saufik-ramadhan/signalforge/proposal/media/pengujian_ir_read.jpg

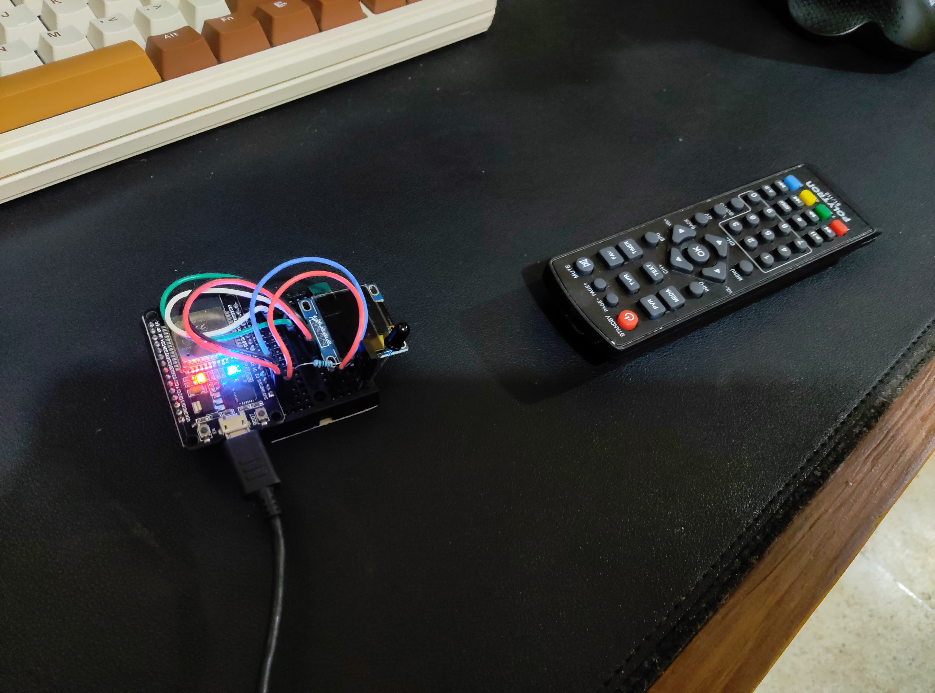
proposal/media/pengujian_ir_read.jpg
