saufik-ramadhan/signalforge/signalforge/Coba Komponen.md

---

kanban-plugin: board

---

## To Buy

- [ ] sx1276
- [ ] batre

## Component

- [ ] pn532
- [ ] oled
- [ ] esp32
- [ ] wifi
- [ ] bms
- [ ] ir

## Try firmware

## Completed

%% kanban:settings
```
{"kanban-plugin":"board","list-collapse":[false,false,false,false]}
```
%%
