saufik-ramadhan/signalforge/proposal/Perancangan_Sistem_Elektronika_4.pptx

## SignalForge (Alat Nirkabel Serbaguna) Implementation and Testing

EL5032 PERANCANGAN SISTEM ELEKTRONIKA
Tim Penyusun:
Mohamad Imam Firdaus (23224002)
Saufik Ramadhan (23222019)


## Abstrak

SignalForge merupakan alat multifungsi untuk penggiat keamanan digital dan siber atau sekadar untuk hobbyst karena kemampuannya untuk membaca, meniru, dan berinteraksi dengan berbagai sinyal radio frekuensi (RF), kartu RFID, dan protokol komunikasi lainnya. Alat ini didesain sebagai alat multi-module yang memudahkan konfigurasi. Setiap modul akan didesain dan diuji dengan metodologi tertentu. Implementasi yang dilakukan secara modular ditujukan agar setiap bagian dapat diverifikasi kesesuaiannya. Pada dokumen ini ditulis kemajuan implementasi dan pengujian dari perangkat keras (hardware) dan perangkat lunak (software) dari setiap modul.

## Pengujian - 1

1. MCU
Microcontroller di hidupkan dan diuji apakah dapat menerima data dari user, dapat membaca data WiFi, dan dapat membaca data Bluetooth.
2. Baterai
Setiap komponen utama menerima suplai daya sesuai dengan kebutuhan dan tidak mengalami drop tegangan dibawah ambang batas.
3. Sub-1 GHz RF module
Berkomunikasi dengan cara mengirimkan text dengan alat sejenis atau alat yang dilengkapi modul yang sama.

## Pengujian - 2

4. Display
Display dapat mengeluarkan button dan teks sesuai program yang ada
5. Buzzer
Dapat mengeluarkan bunyi sebagai feedback.
6. Infrared
Membaca dan mereplay ulang data dari remote. Hasil akan dibandingkan dengan suatu remote control.
7. NFC
Membaca dan menulis data pada generic RFID card.

## Pengujian - 3

8. GPIO
Membaca sinyal dari button yang dipasang secara terpisah dari button utama.
9. MicroSD
Menyimpan suatu text dari user lalu membaca kembali text tersebut setelah daya dimatikan.
10. Body
Body dirangkai dan diperhatikan apakah seluruh komponen terpasang sesuai dengan desain.

## Design Tools 1 – Arduino IDE

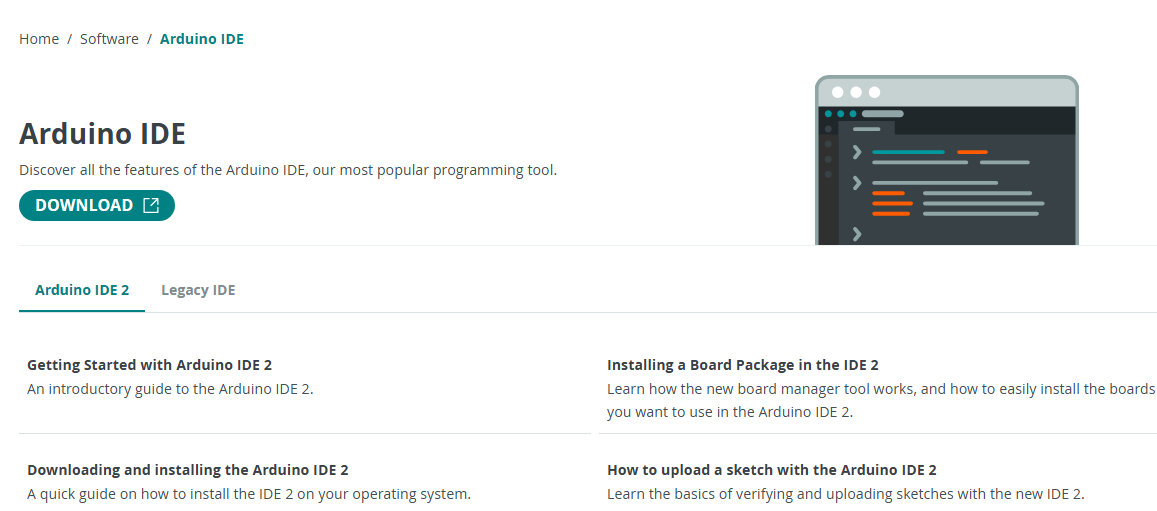
[picture p21: figure]

## Design Tools 2 – Arduino CLI

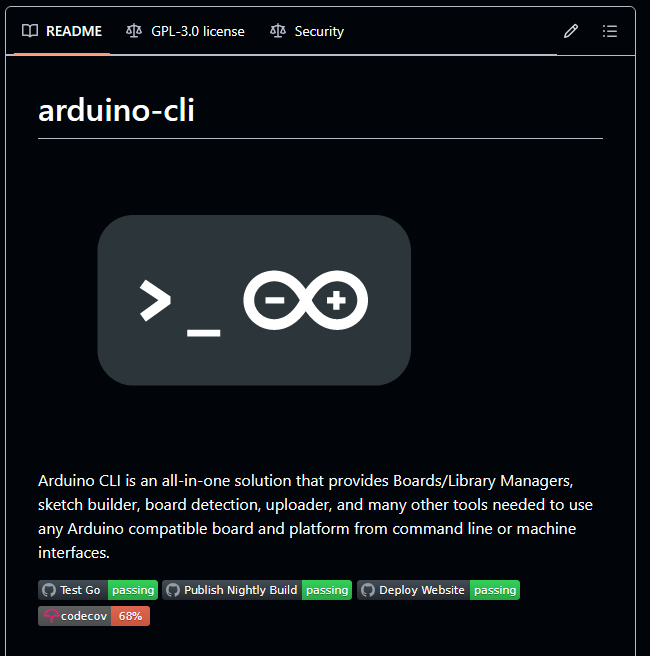
[picture p22: figure]

## Additional Note

- A lot of module means the needs for bigger binary
- Solution:
- Load from SD Card
- Mechanism:
- Use File system module and OTA Module

## Design Tools 3 - FreeCAD

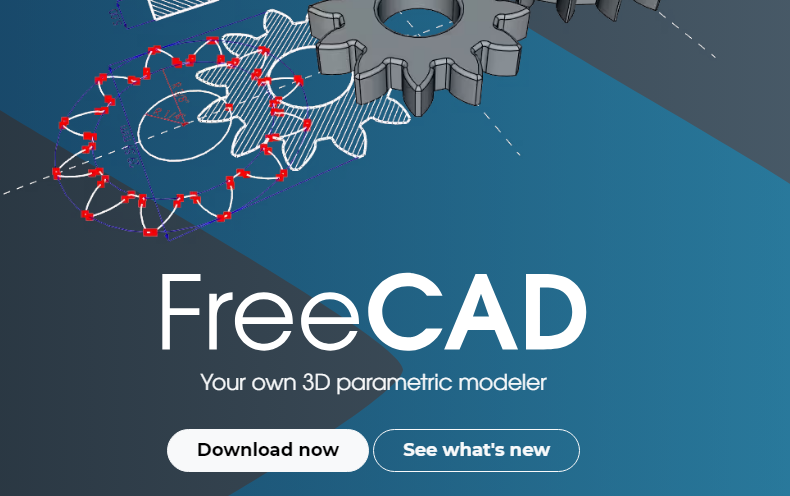
[picture p23: figure]

## Design Tools 4 - KiCad

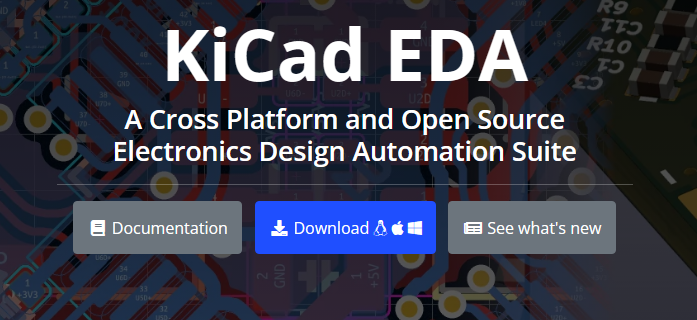
[picture p24: figure]

## Modul 1 – Microcontroller + Wireless

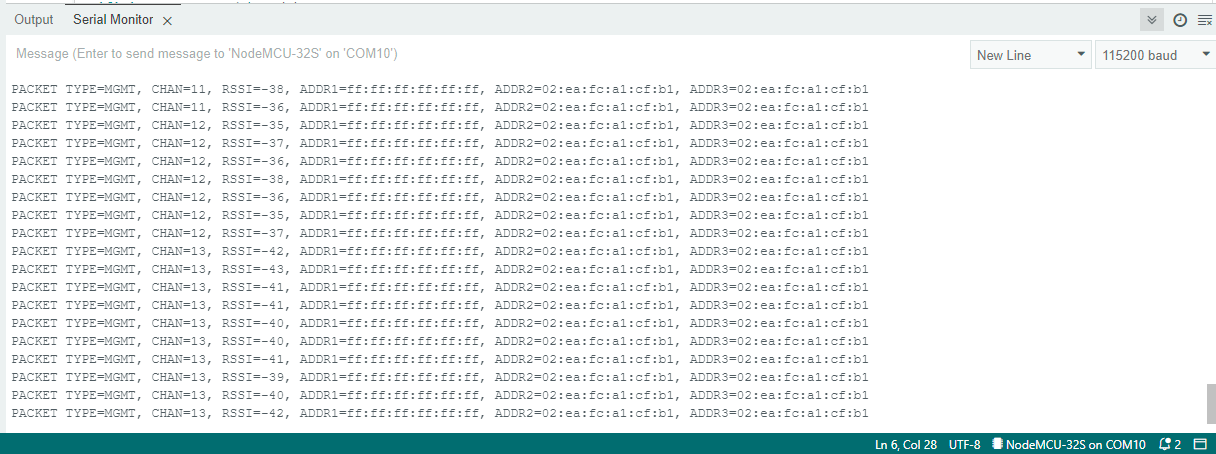
[picture p25: figure]
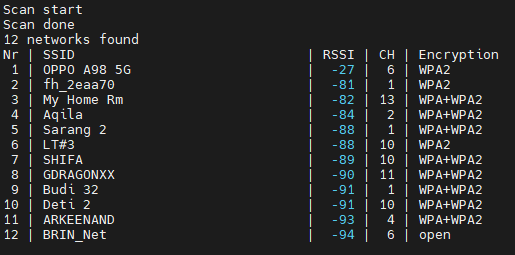
[picture p26: figure]

## Module 1

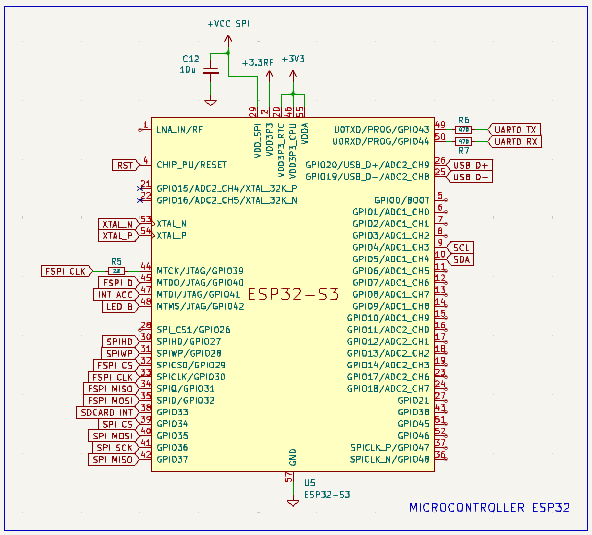
[picture p27: figure]
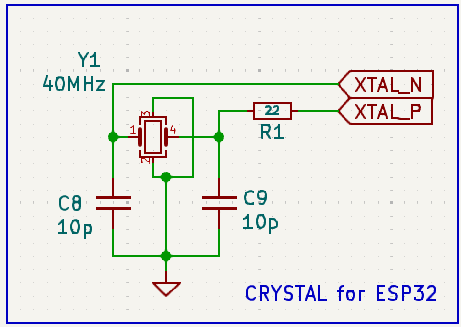
[picture p28: figure]

## Module 1

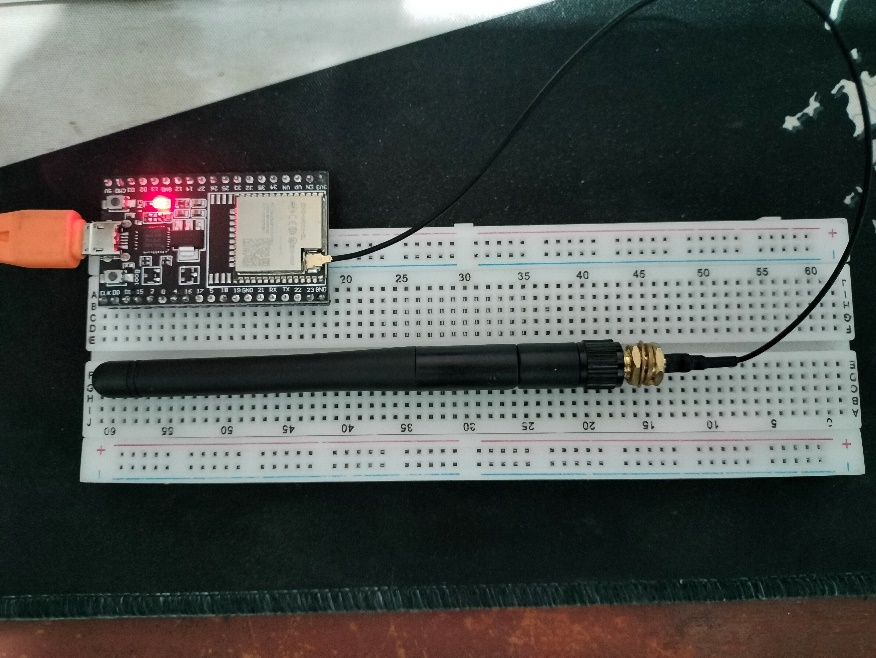
[picture p29: figure]

## Module 2 – Power Electronics

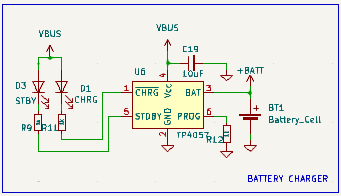
[picture p30: figure]
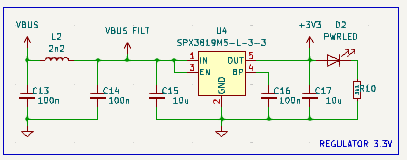
[picture p31: figure]
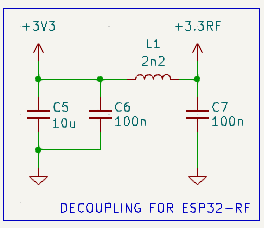
[picture p32: figure]
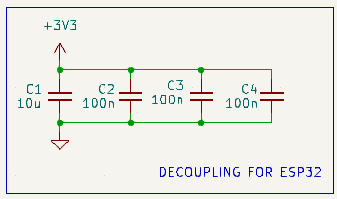
[picture p33: figure]

## Module 3 - RF

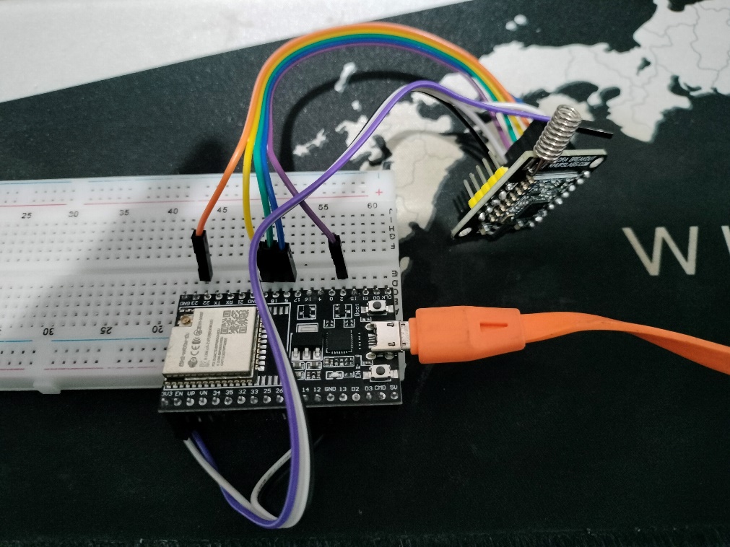
[picture p34: figure]

## Modul 4 – UI Module

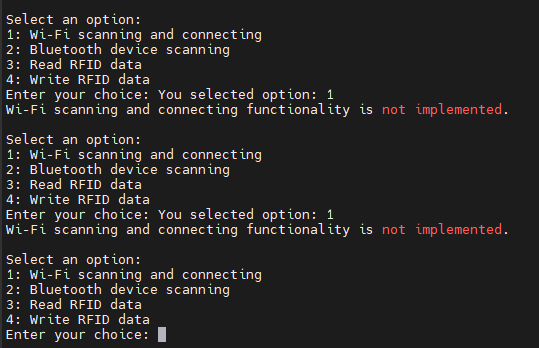
[picture p35: figure]

## Module 4

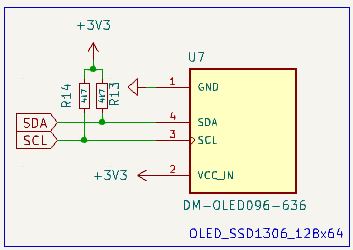
[picture p36: figure]
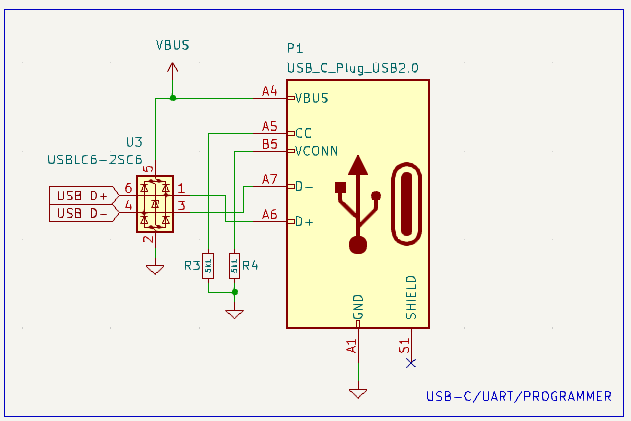
[picture p37: figure]
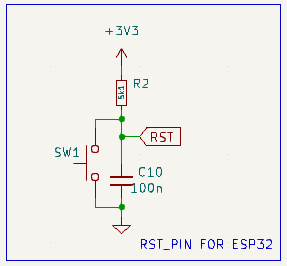
[picture p38: figure]

## Modul 5 – IR Module

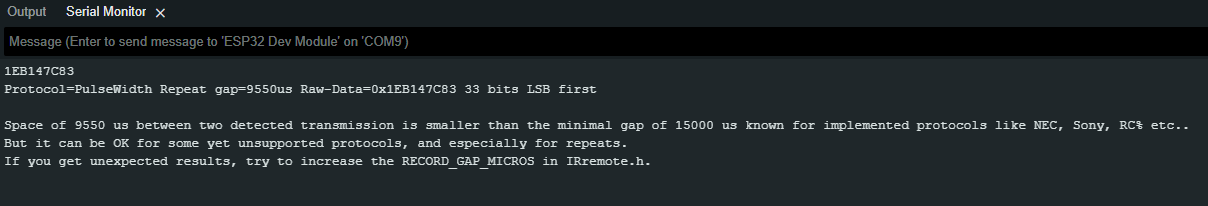
[picture p39: figure]

## Module 5

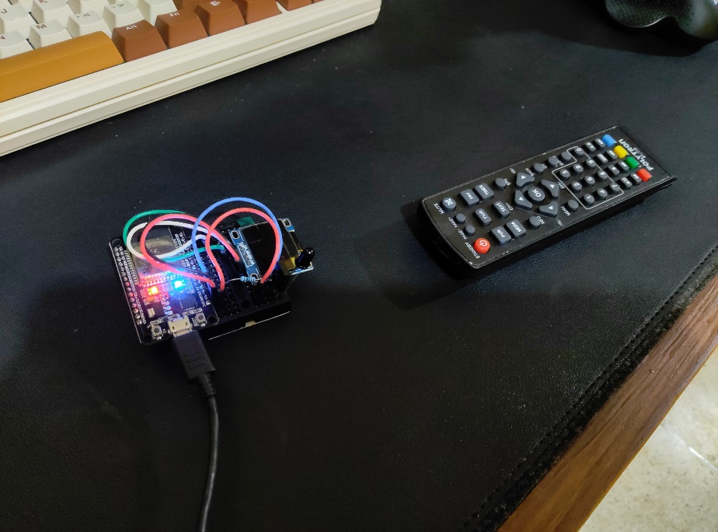
[picture p40: figure]

## Module 5

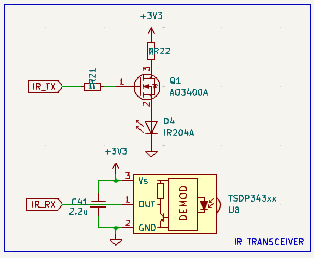
[picture p41: figure]

## Module 6 - NFC

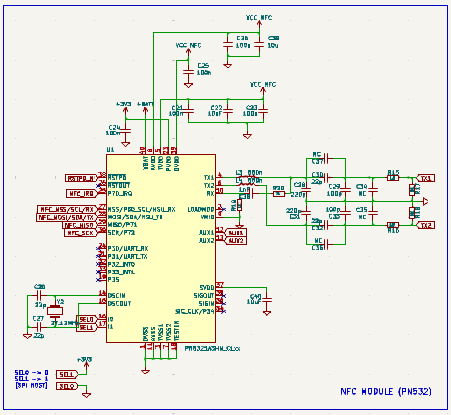
[picture p42: figure]

## Module 6

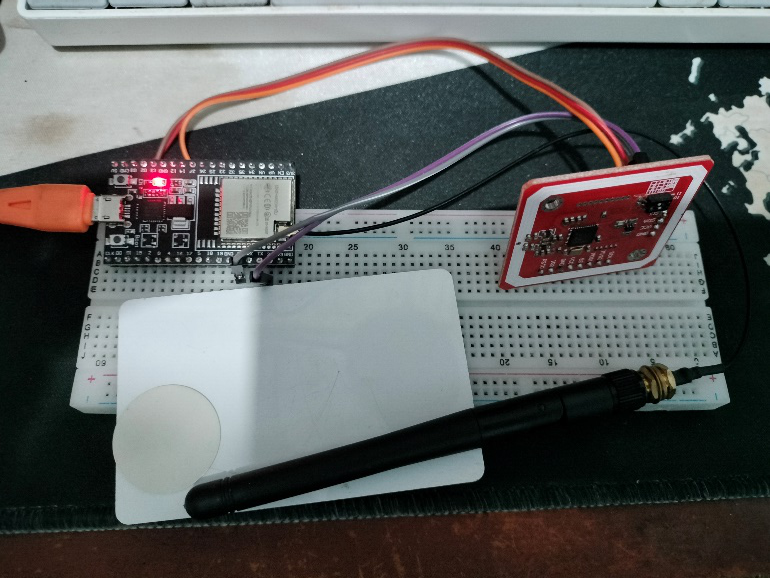
[picture p43: figure]

## Module 7 – Storage

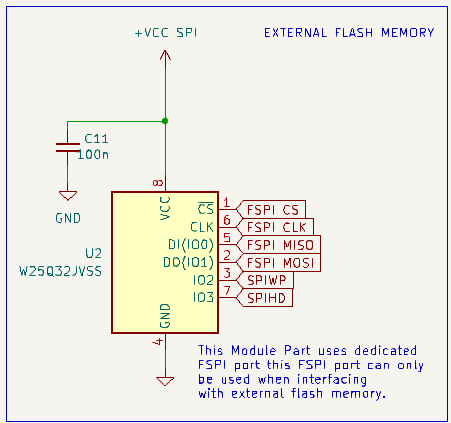
[picture p44: figure]
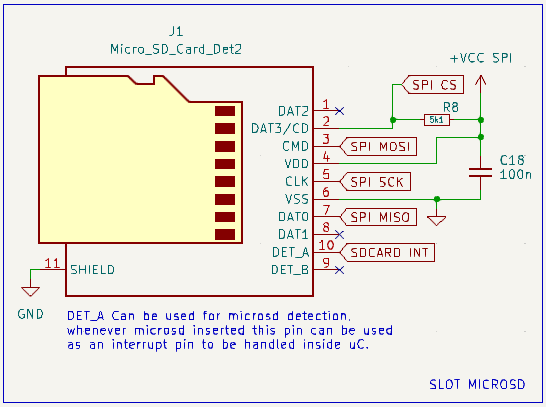
[picture p45: figure]

## Sekian dan Terima Kasih
