saufik-ramadhan/signalforge/hardware/Casing_Acrilic/export_shape4.pdf

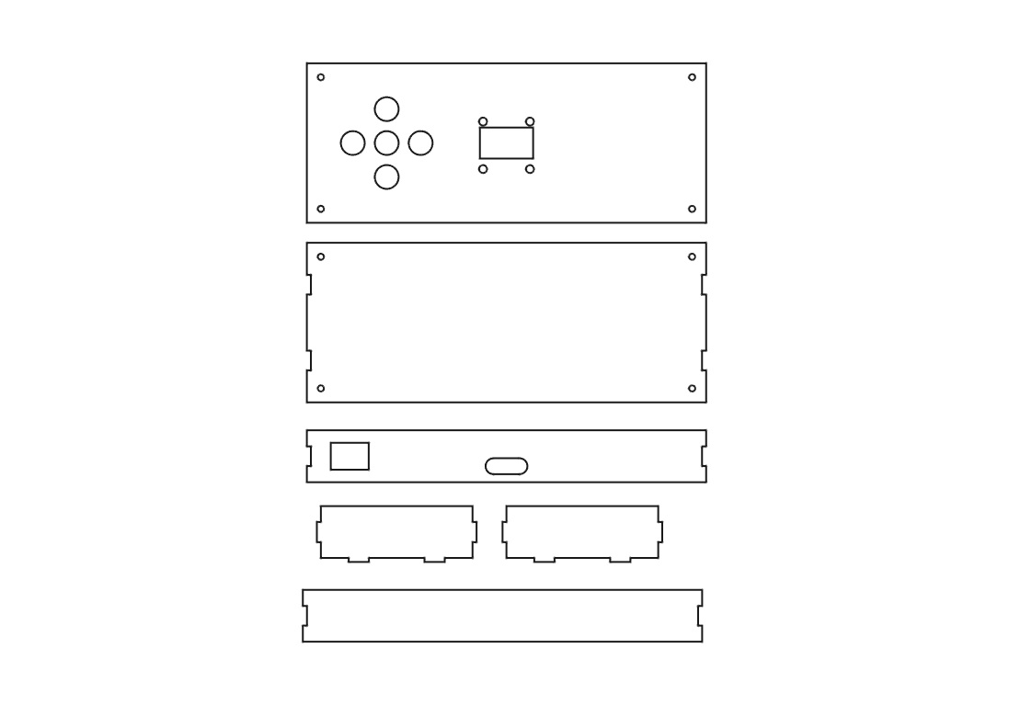
[picture p69: page 1]
