saufik-ramadhan/signalforge/hardware/Casing_Acrilic/casing.pdf

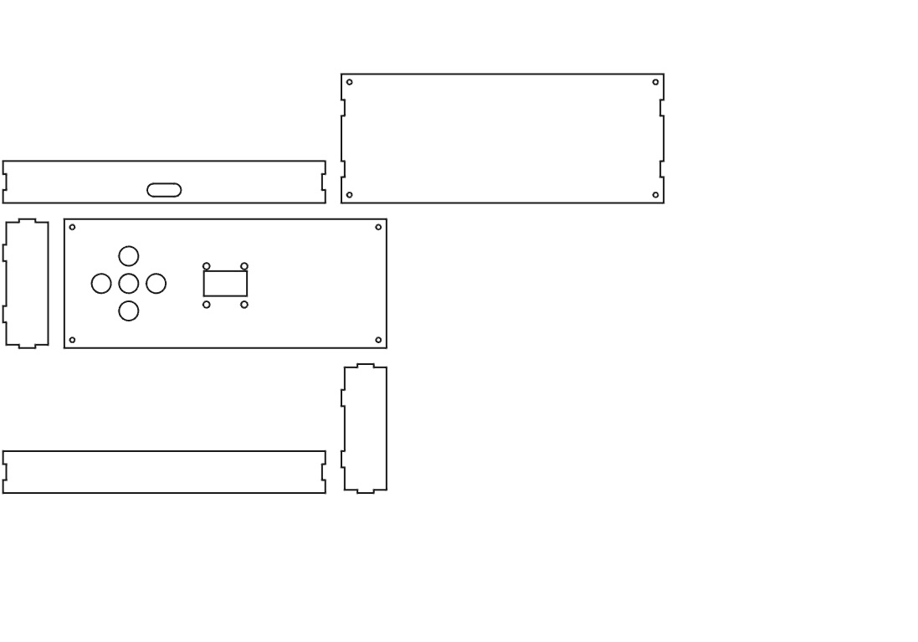
[picture p70: page 1]
