saufik-ramadhan/signalforge/hardware/Casing_Acrilic/export_shape1.pdf

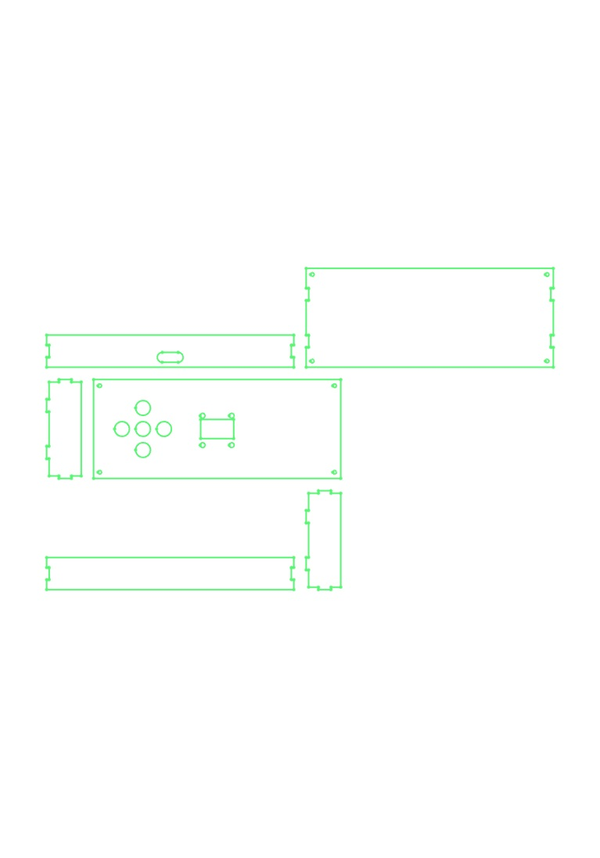
[picture p71: page 1]
