saufik-ramadhan/signalforge/proposal/media/Screenshot 2025-01-05 110854.png

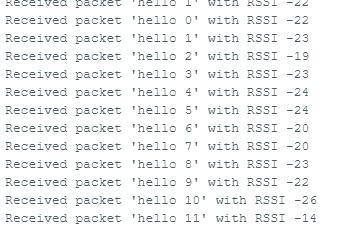
proposal/media/Screenshot 2025-01-05 110854.png
