saufik-ramadhan/signalforge/proposal/media/Screenshot 2025-01-05 111706.png

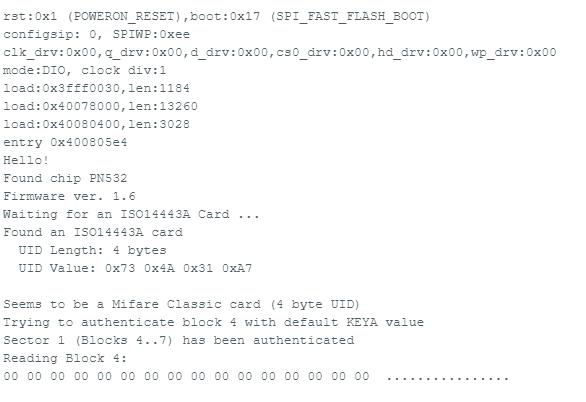
proposal/media/Screenshot 2025-01-05 111706.png
