saufik-ramadhan/signalforge/proposal/media/Top Level Block Diagram.drawio.png

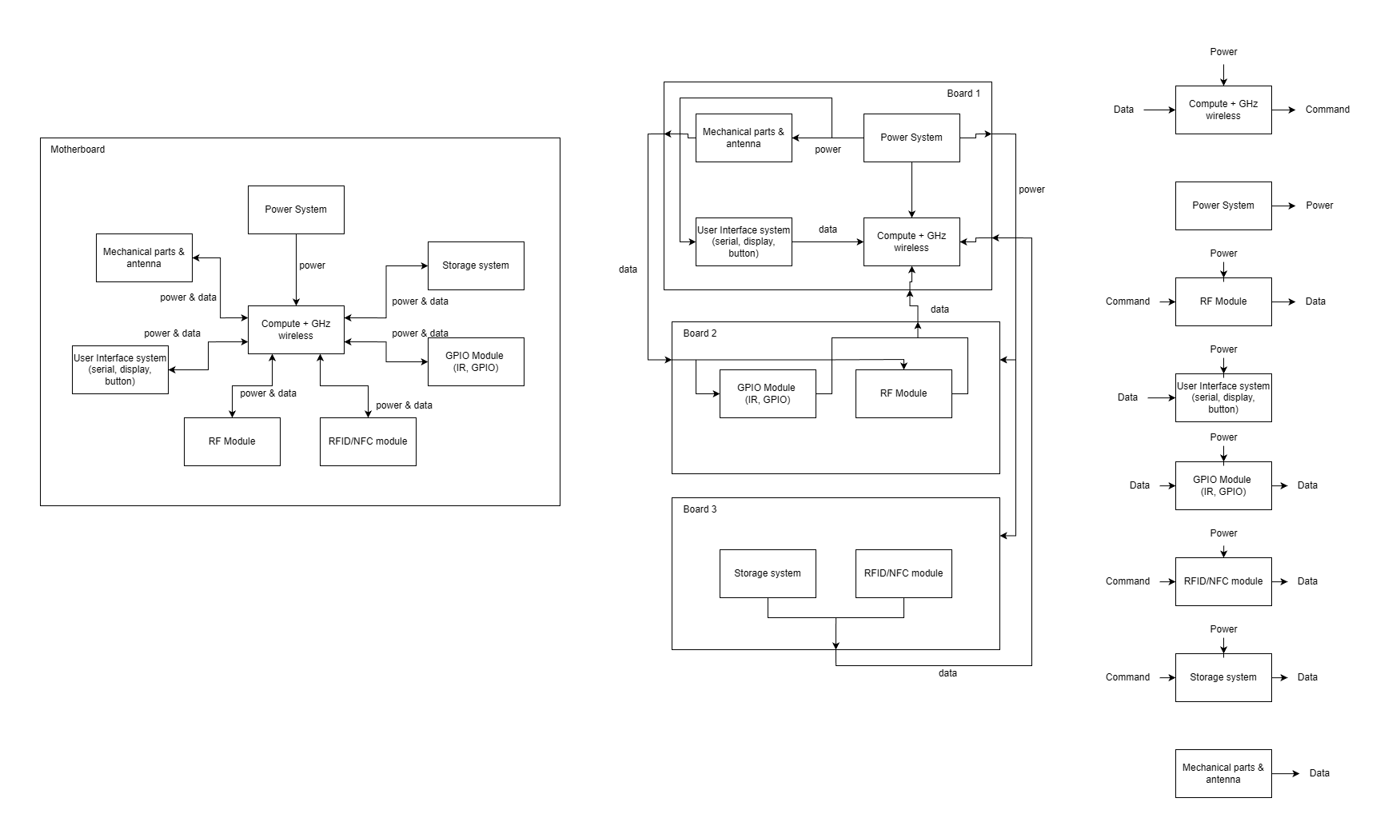
proposal/media/Top Level Block Diagram.drawio.png
