saufik-ramadhan/signalforge/signalforge/Component.md

- 52Kohm resistor
- 100Kohm resistor

- LX-LBC3 charging/discharging module
- 2-way switch button

- 1 IR Receiver, 1 IR Emitter
- 8 pin female socket
- 22 pin female socket(2pcs.)
- SX1276
- PN532

- SD Card socket
- ST7789 display(1.54 inch)

- ESP32-S3-DevKitC-1
- 18650 3.3v battery and 18650 battery socket or a LiPo battery

---

nrf24l01
pn532

esp32 devkit v4
oled

battery charging
stepdown dc-dc
ir transceiver
