saufik-ramadhan/signalforge/proposal/Rincian Biaya.xlsx

NO | Part | Satuan | Harga
1 | Microprocessor / Microcontroller :
 | ESP32-C6 | 1 | Rp 135000
 | RP2040 (alternatives) | 1 | Rp 51000
2 | NFC Reader (13.56MHz) : | 1 | Rp 50000
 | PN532
3 | 2.4GHz Wireless Module : | 1 | Rp 23000
 | NRF24L01
4 | IR Transceiver (Packet) | 1 | Rp 5000
5 | Displays: | 1 | Rp 30000
 | 128x64 0.96” OLED
6 | RFID 125KHz Reader : | 1 | Rp 52000
 | 7941E
7 | 2000 mah Li-Po Battery | 1 | Rp 42000
8 | Casing | 1 | Rp 50000
9 | Resistors and Capacitors | 1 Set | Rp 30000
10 | Push Buttons | 1 Set | Rp 10000
11 | PCB Fabrication |  | Rp 80000
 |  |  | Rp 558000
