saufik-ramadhan/signalforge/hardware/Casing_3DPrint-Body002.step

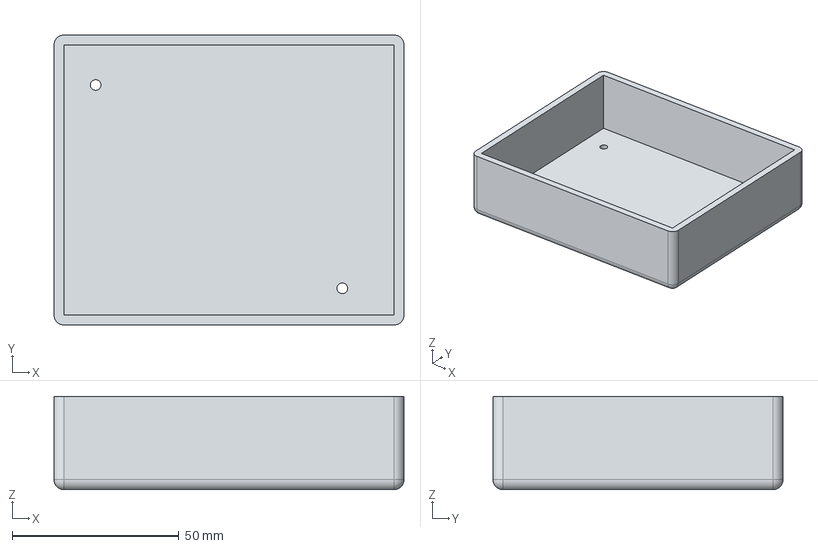
[picture p75: CAD file, 2025-01-05]
hardware/Casing_3DPrint-Body002.step
105.0 x 87.0 x 28.0 mm
