saufik-ramadhan/signalforge/hardware/Casing_3DPrint/Casing_3DPrint.FCStd

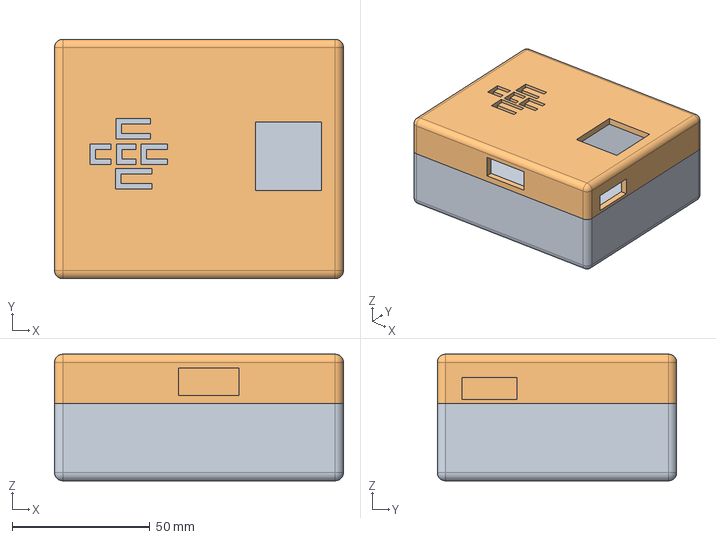
[picture p76: CAD file, 2025-01-06]
hardware/Casing_3DPrint/Casing_3DPrint.FCStd
105.0 x 87.0 x 46.0 mm
