saufik-ramadhan/signalforge/hardware/Casing_3DPrint_2/version3-2.FCStd

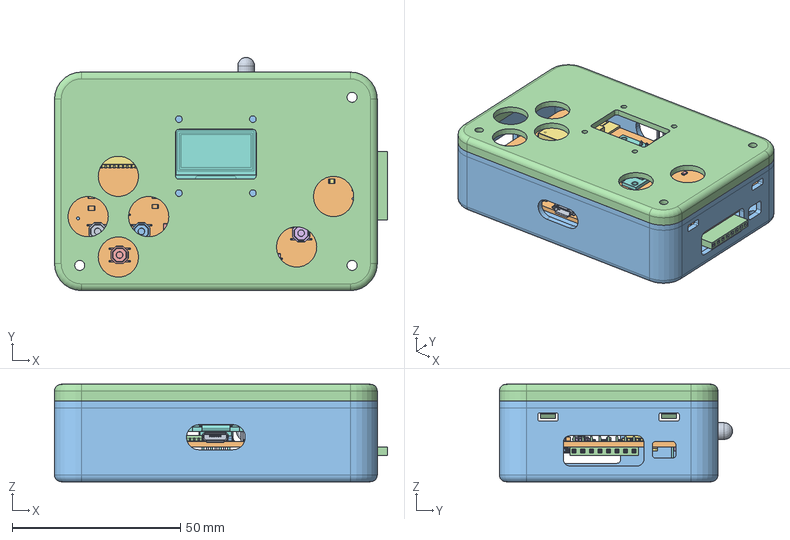
[picture p77: CAD file, 2025-01-24]
hardware/Casing_3DPrint_2/version3-2.FCStd
99.0 x 69.4 x 29.0 mm
PinHeader_1x03_P254mm_Vertical
C_0805_2012Metric
SW_SPST_TL3342
SOT_23
R_0805_2012Metric
SW_SPST_TL3344
R_0805_2012Metric002
R_0805_2012Metric004
SW_SPST_TL3346
R_0805_2012Metric006
SOT_23_5
SOIC_16_39x99mm_P127mm
SW_SPST_TL3348
C_0805_2012Metric002
LED_0805_2012Metric
C_0805_2012Metric004
LED_D5.0mm_Horizontal_O1.27mm_Z3.0mm
R_0805_2012Metric008
D_SOD_123F
R_0805_2012Metric010
R_0805_2012Metric012
SW_SPST_TL3350
R_0805_2012Metric014
SOT_024
R_0805_2012Metric016
R_0805_2012Metric018
R_0805_2012Metric020
R_0805_2012Metric022
R_0805_2012Metric024
SW_SPST_TL3352
ESP32-WROOM-32
DM-OLED096-636
C-1981568-1
C_0805_2012Metric006
R_0805_2012Metric026
LED_0805_2012Metric002
C_0805_2012Metric008
SOT_025
SOT_026
C_0805_2012Metric010
R_0805_2012Metric028
TSOT_23_5
CUI_DEVICES_MSD-2-A
R_0805_2012Metric030
R_0805_2012Metric032
C_0805_2012Metric012
C_0805_2012Metric014
R_0805_2012Metric034
C_0805_2012Metric016
R_0805_2012Metric036
R_0805_2012Metric038
PinSocket_1x08_P254mm_Horizontal
R_0805_2012Metric040
C_0805_2012Metric018
JST_S2B_EH
R_0805_2012Metric042
R_0805_2012Metric044
SignalForgeV1.0_PCB
