saufik-ramadhan/signalforge/hardware/Casing_Acrilic/MultiJoin_preview_parts1.FCStd

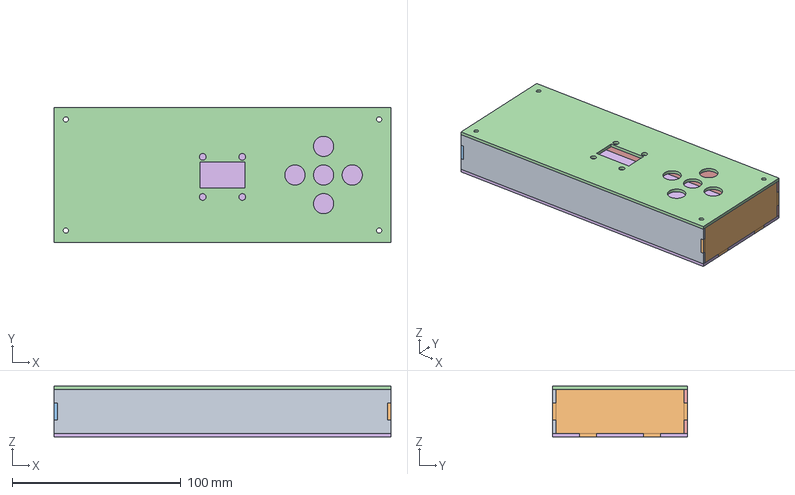
[picture p78: CAD file, 2025-01-06]
hardware/Casing_Acrilic/MultiJoin_preview_parts1.FCStd
200.0 x 80.0 x 30.0 mm
behind_panel_tab
left_panel_tab
right_panel_tab
