saufik-ramadhan/signalforge/hardware/PCB/Casing_3DPrint.FCStd

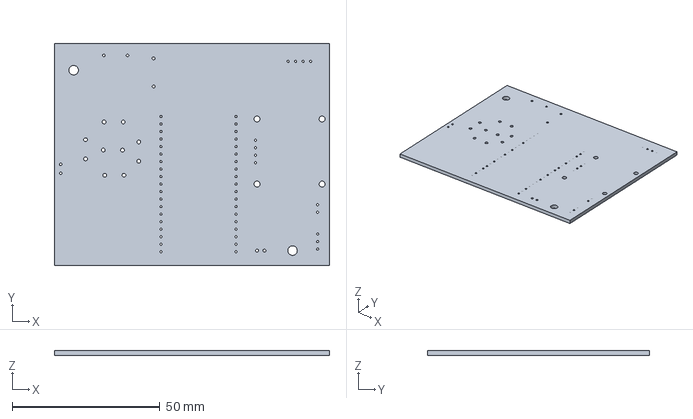
[picture p79: CAD file, 2025-01-05]
hardware/PCB/Casing_3DPrint.FCStd
93.0 x 75.0 x 1.60 mm
