saufik-ramadhan/signalforge/hardware/Casing_3DPrint-Body001.step

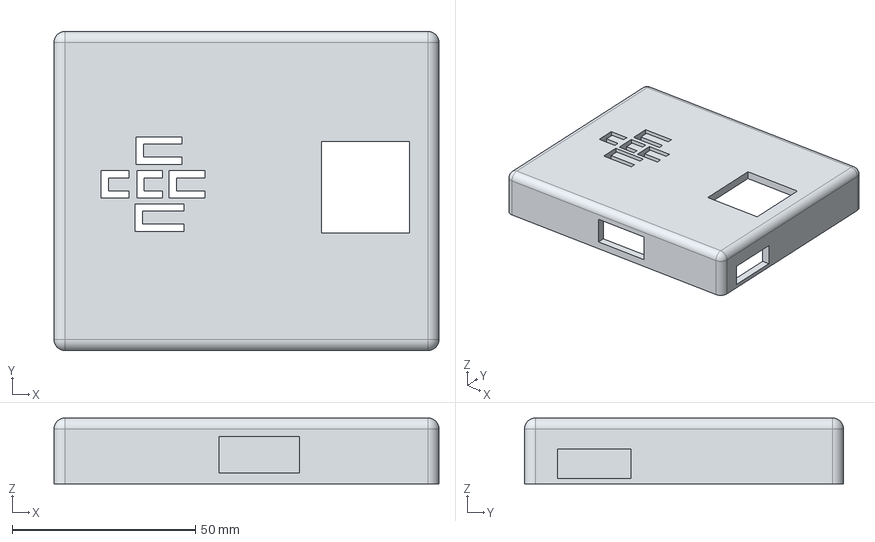
[picture p80: CAD file, 2025-01-05]
hardware/Casing_3DPrint-Body001.step
105.0 x 87.0 x 18.0 mm
