saufik-ramadhan/signalforge/hardware/Casing_3DPrint_2/version3-2-Body002.step

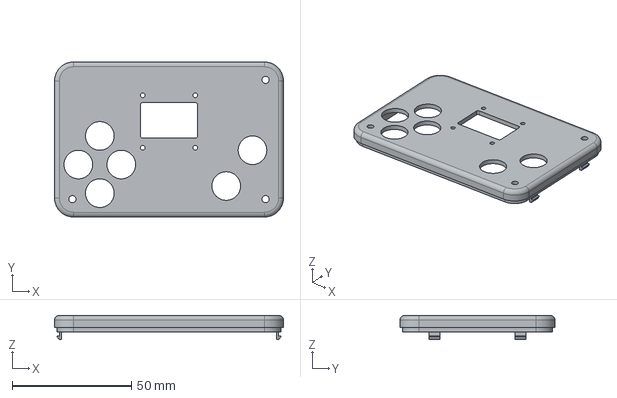
[picture p81: CAD file, 2025-01-23]
hardware/Casing_3DPrint_2/version3-2-Body002.step
96.0 x 65.0 x 10.2 mm
