saufik-ramadhan/signalforge/hardware/Casing_Acrilic/export_shape3.dxf

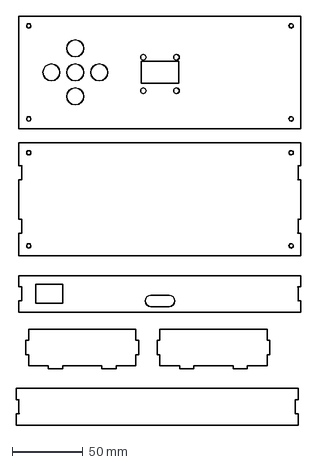
[picture p82: CAD file, 2025-01-05]
hardware/Casing_Acrilic/export_shape3.dxf
202.0 x 290.0 mm
