saufik-ramadhan/signalforge/hardware/Casing_3DPrint_2/version3-Body.step

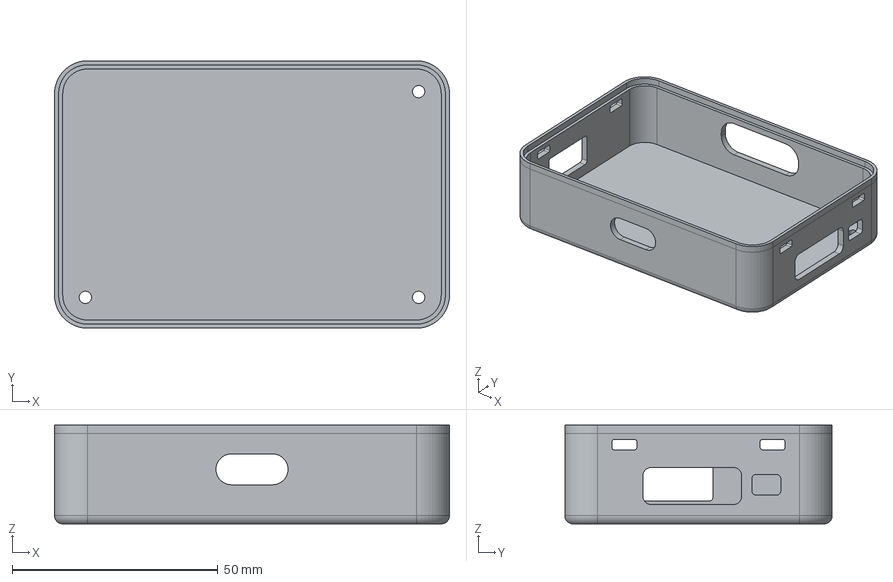
[picture p83: CAD file, 2025-01-23]
hardware/Casing_3DPrint_2/version3-Body.step
96.0 x 65.0 x 24.0 mm
