saufik-ramadhan/signalforge/(list of files, cad)

Other CAD files:
hardware/Casing_Acrilic/export_shape2.FCStd
hardware/Casing_Acrilic/export_shape1.FCStd
