saufik-ramadhan/signalforge/signalforge/Todo List.md

- [ ] Update document
- [ ] Layout
- [ ] Try componet
- [ ] Firmware
- [ ] Hack together gui or some stuff

- [ ] Menu
- [ ] IR
- [ ] Schematic

- [ ] Wifi
- [ ] Bluetooth
- [ ] NFC

- [ ] Dokumen
- [ ] PTT
