saufik-ramadhan/signalforge/hardware/Casing_Acrilic/export_shape_2.pdf

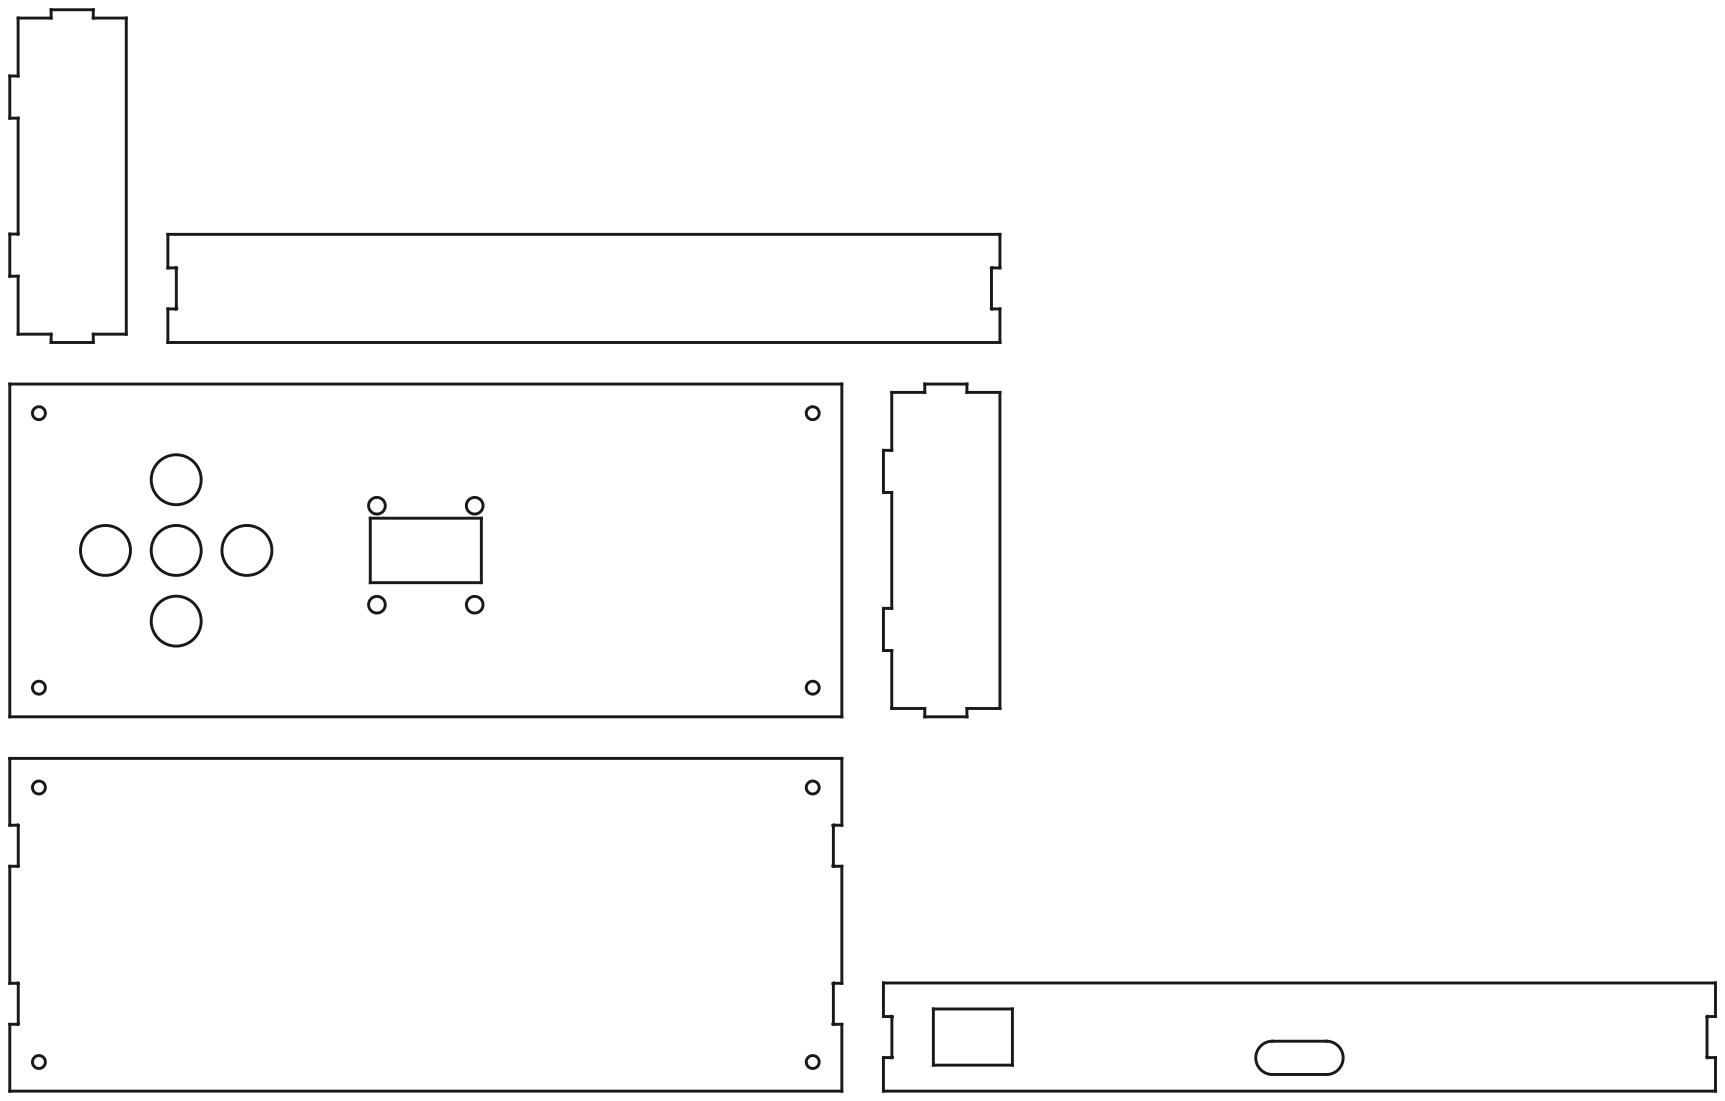
[picture p85: page 1]
