saufik-ramadhan/signalforge/hardware/Casing_Acrilic/export_shape_4.pdf

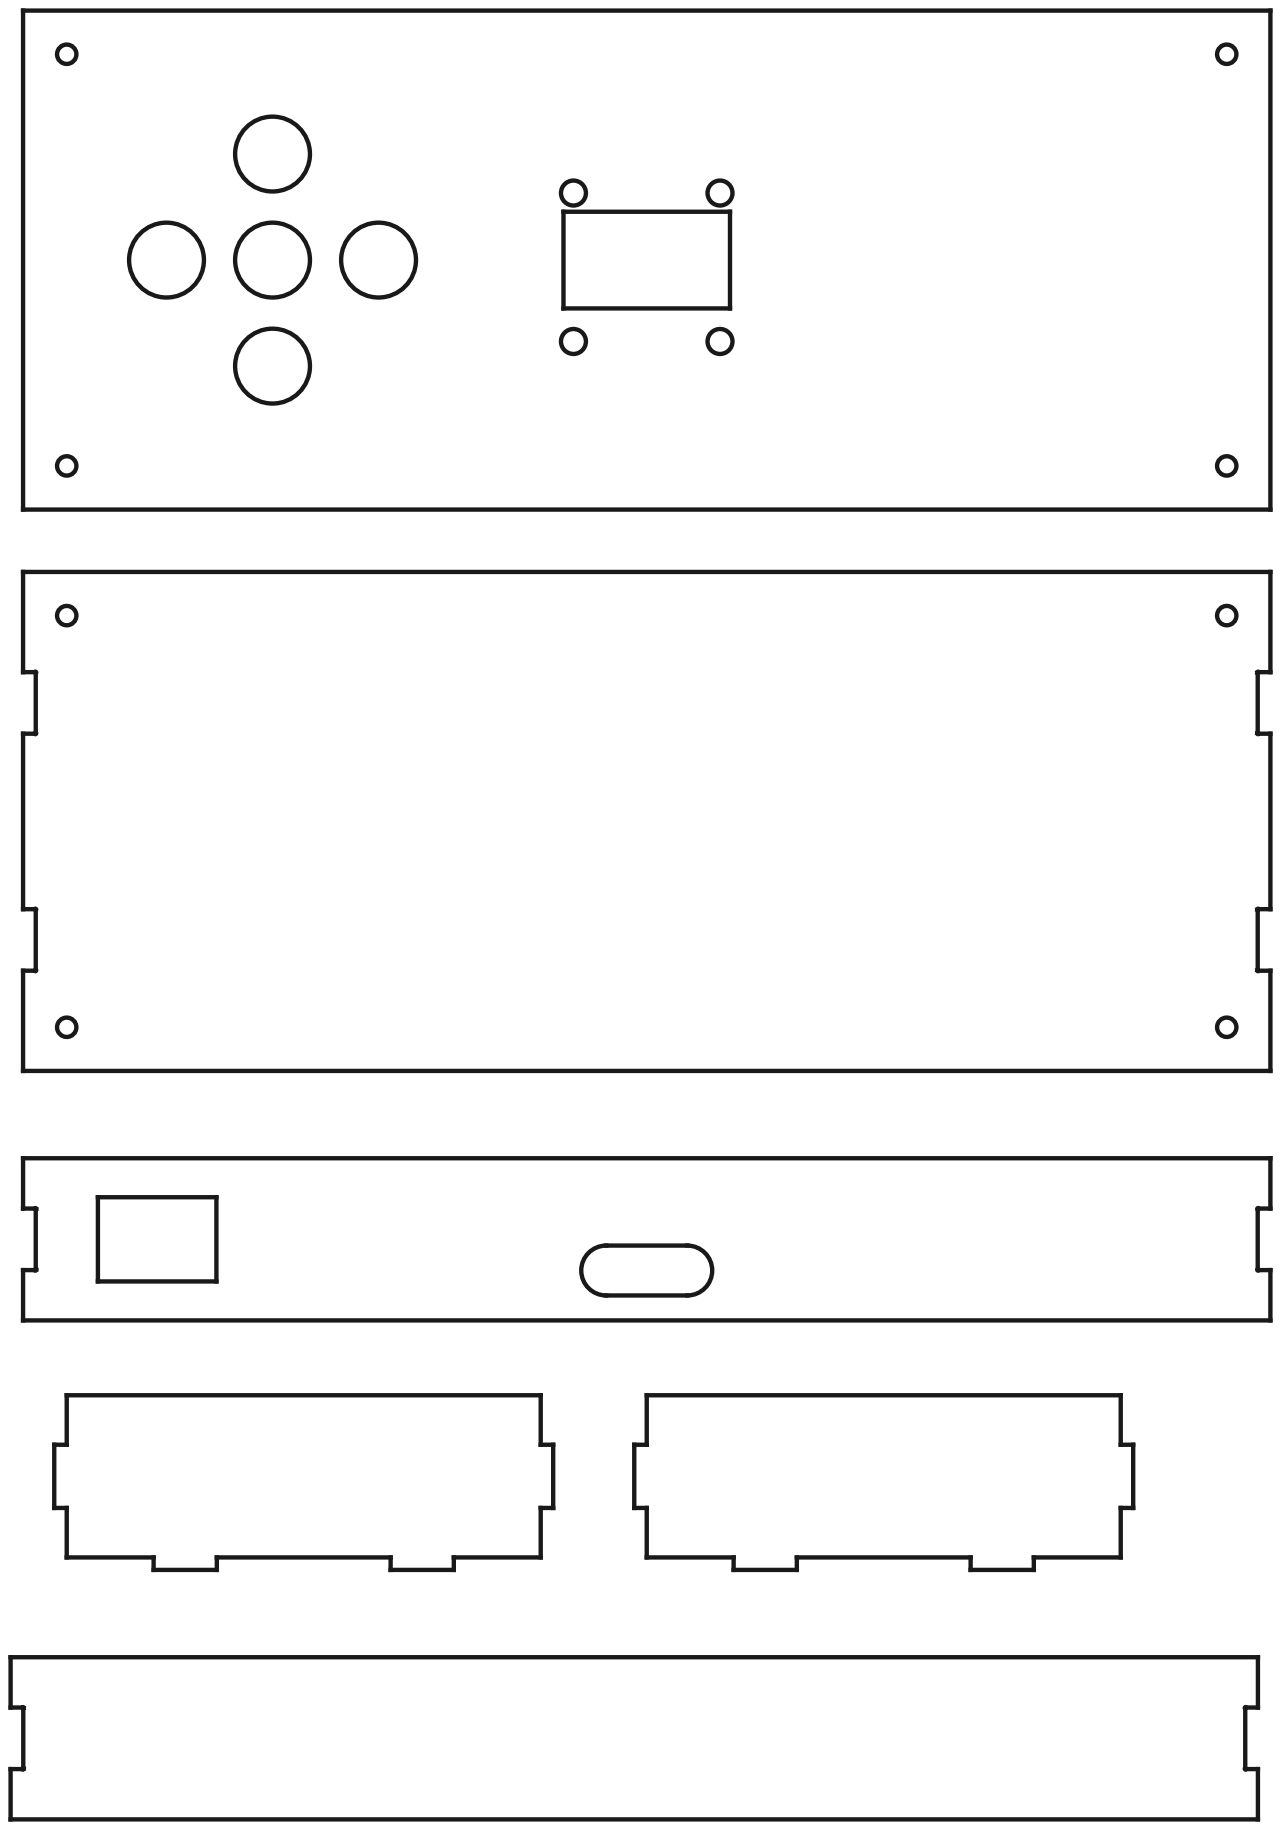
[picture p86: page 1]
