saufik-ramadhan/signalforge/hardware/Casing_Acrilic/export_shape_1.pdf

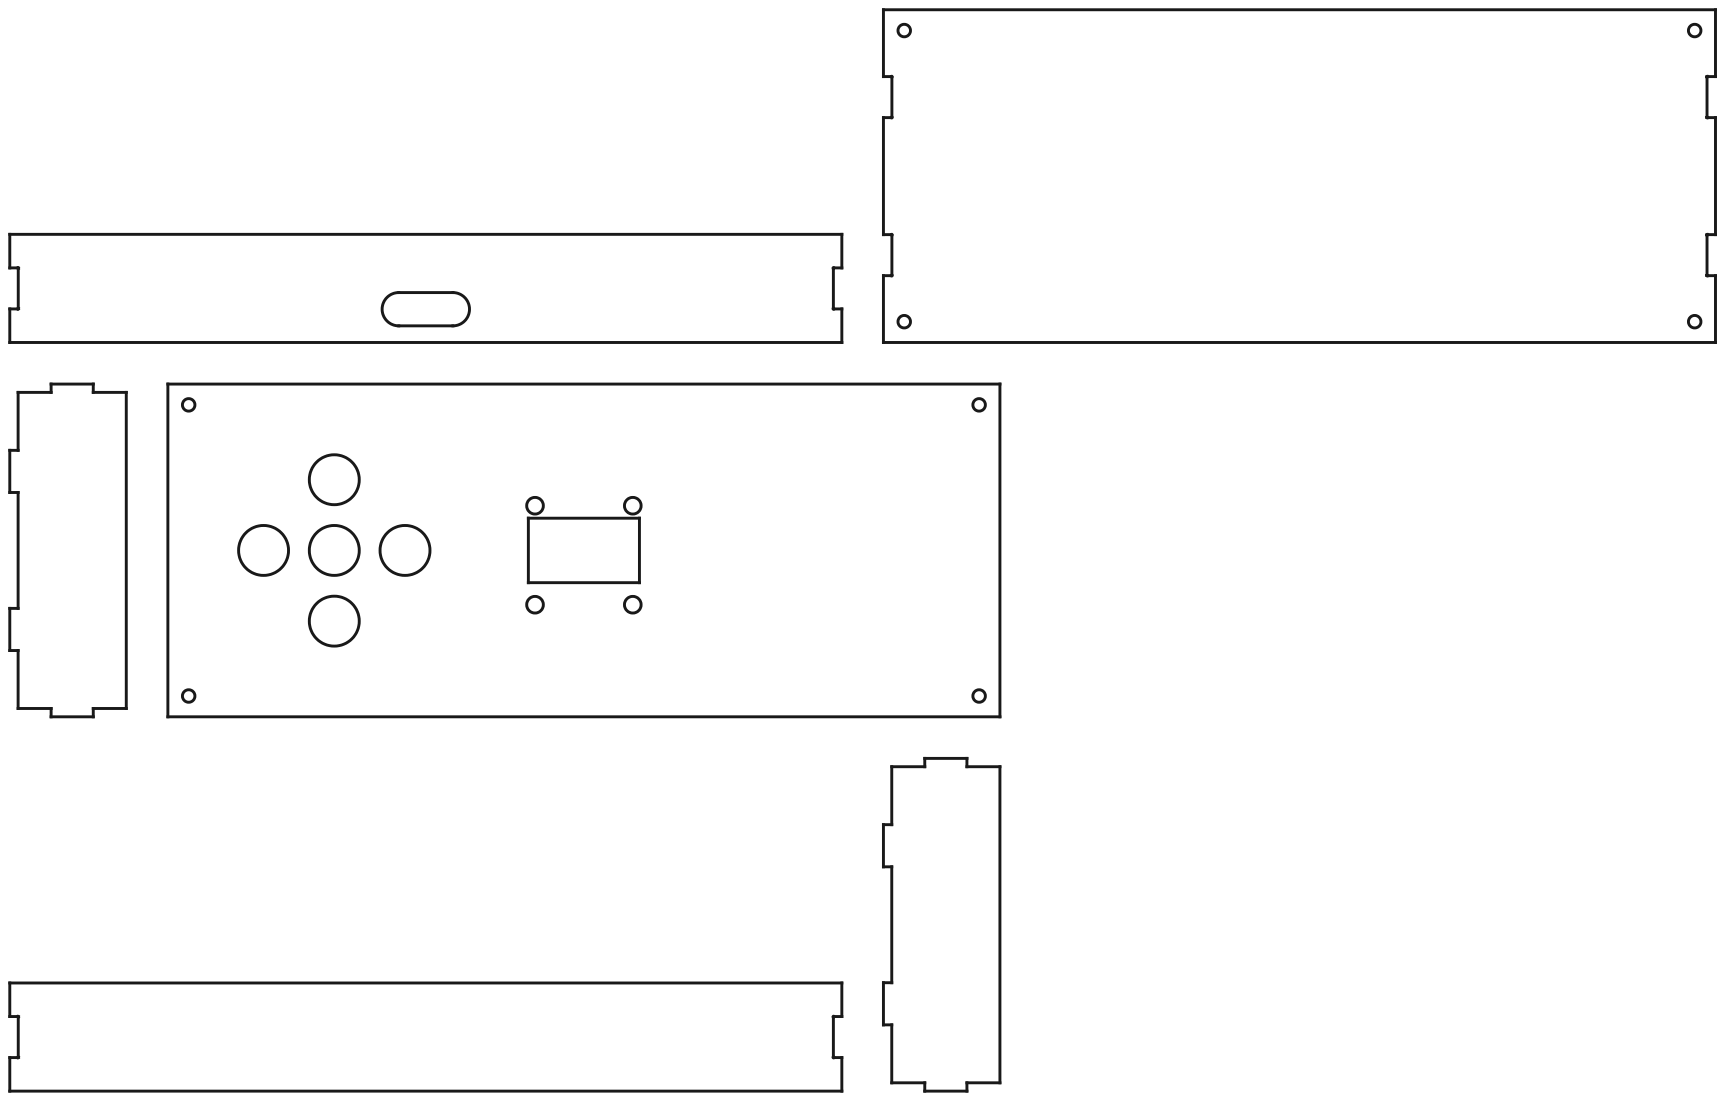
[picture p87: page 1]
