saufik-ramadhan/signalforge/hardware/SignalForge-PCB/PCB/Gerbers/PDF/PCB-B_Silkscreen.pdf

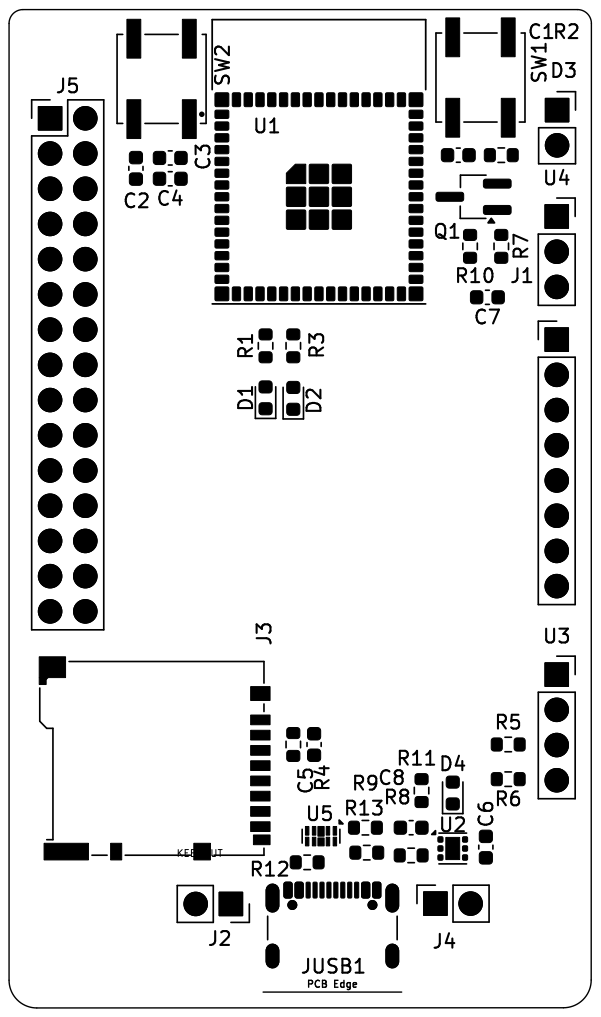
[picture p88: page 1]
