saufik-ramadhan/signalforge/hardware/SignalForge-PCB/PCB/Gerbers/PDF/PCB-User_Comments.pdf

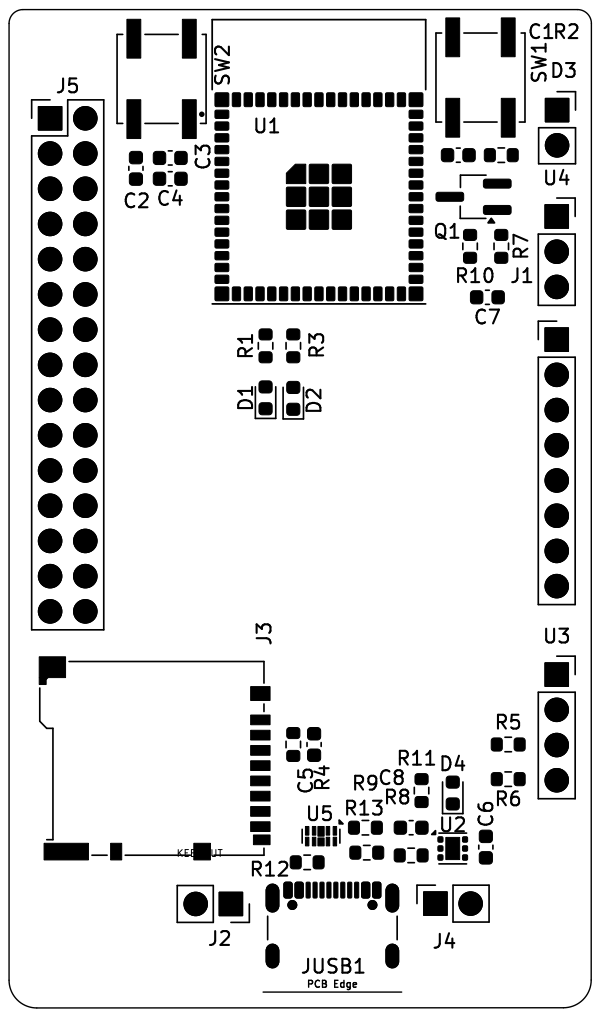
[picture p89: page 1]
