saufik-ramadhan/signalforge/hardware/SignalForge-V5/PCB/PCB.kicad_pcb

## KiCad design hardware/SignalForge-V5/PCB/PCB.kicad_pcb (2025-01-02)

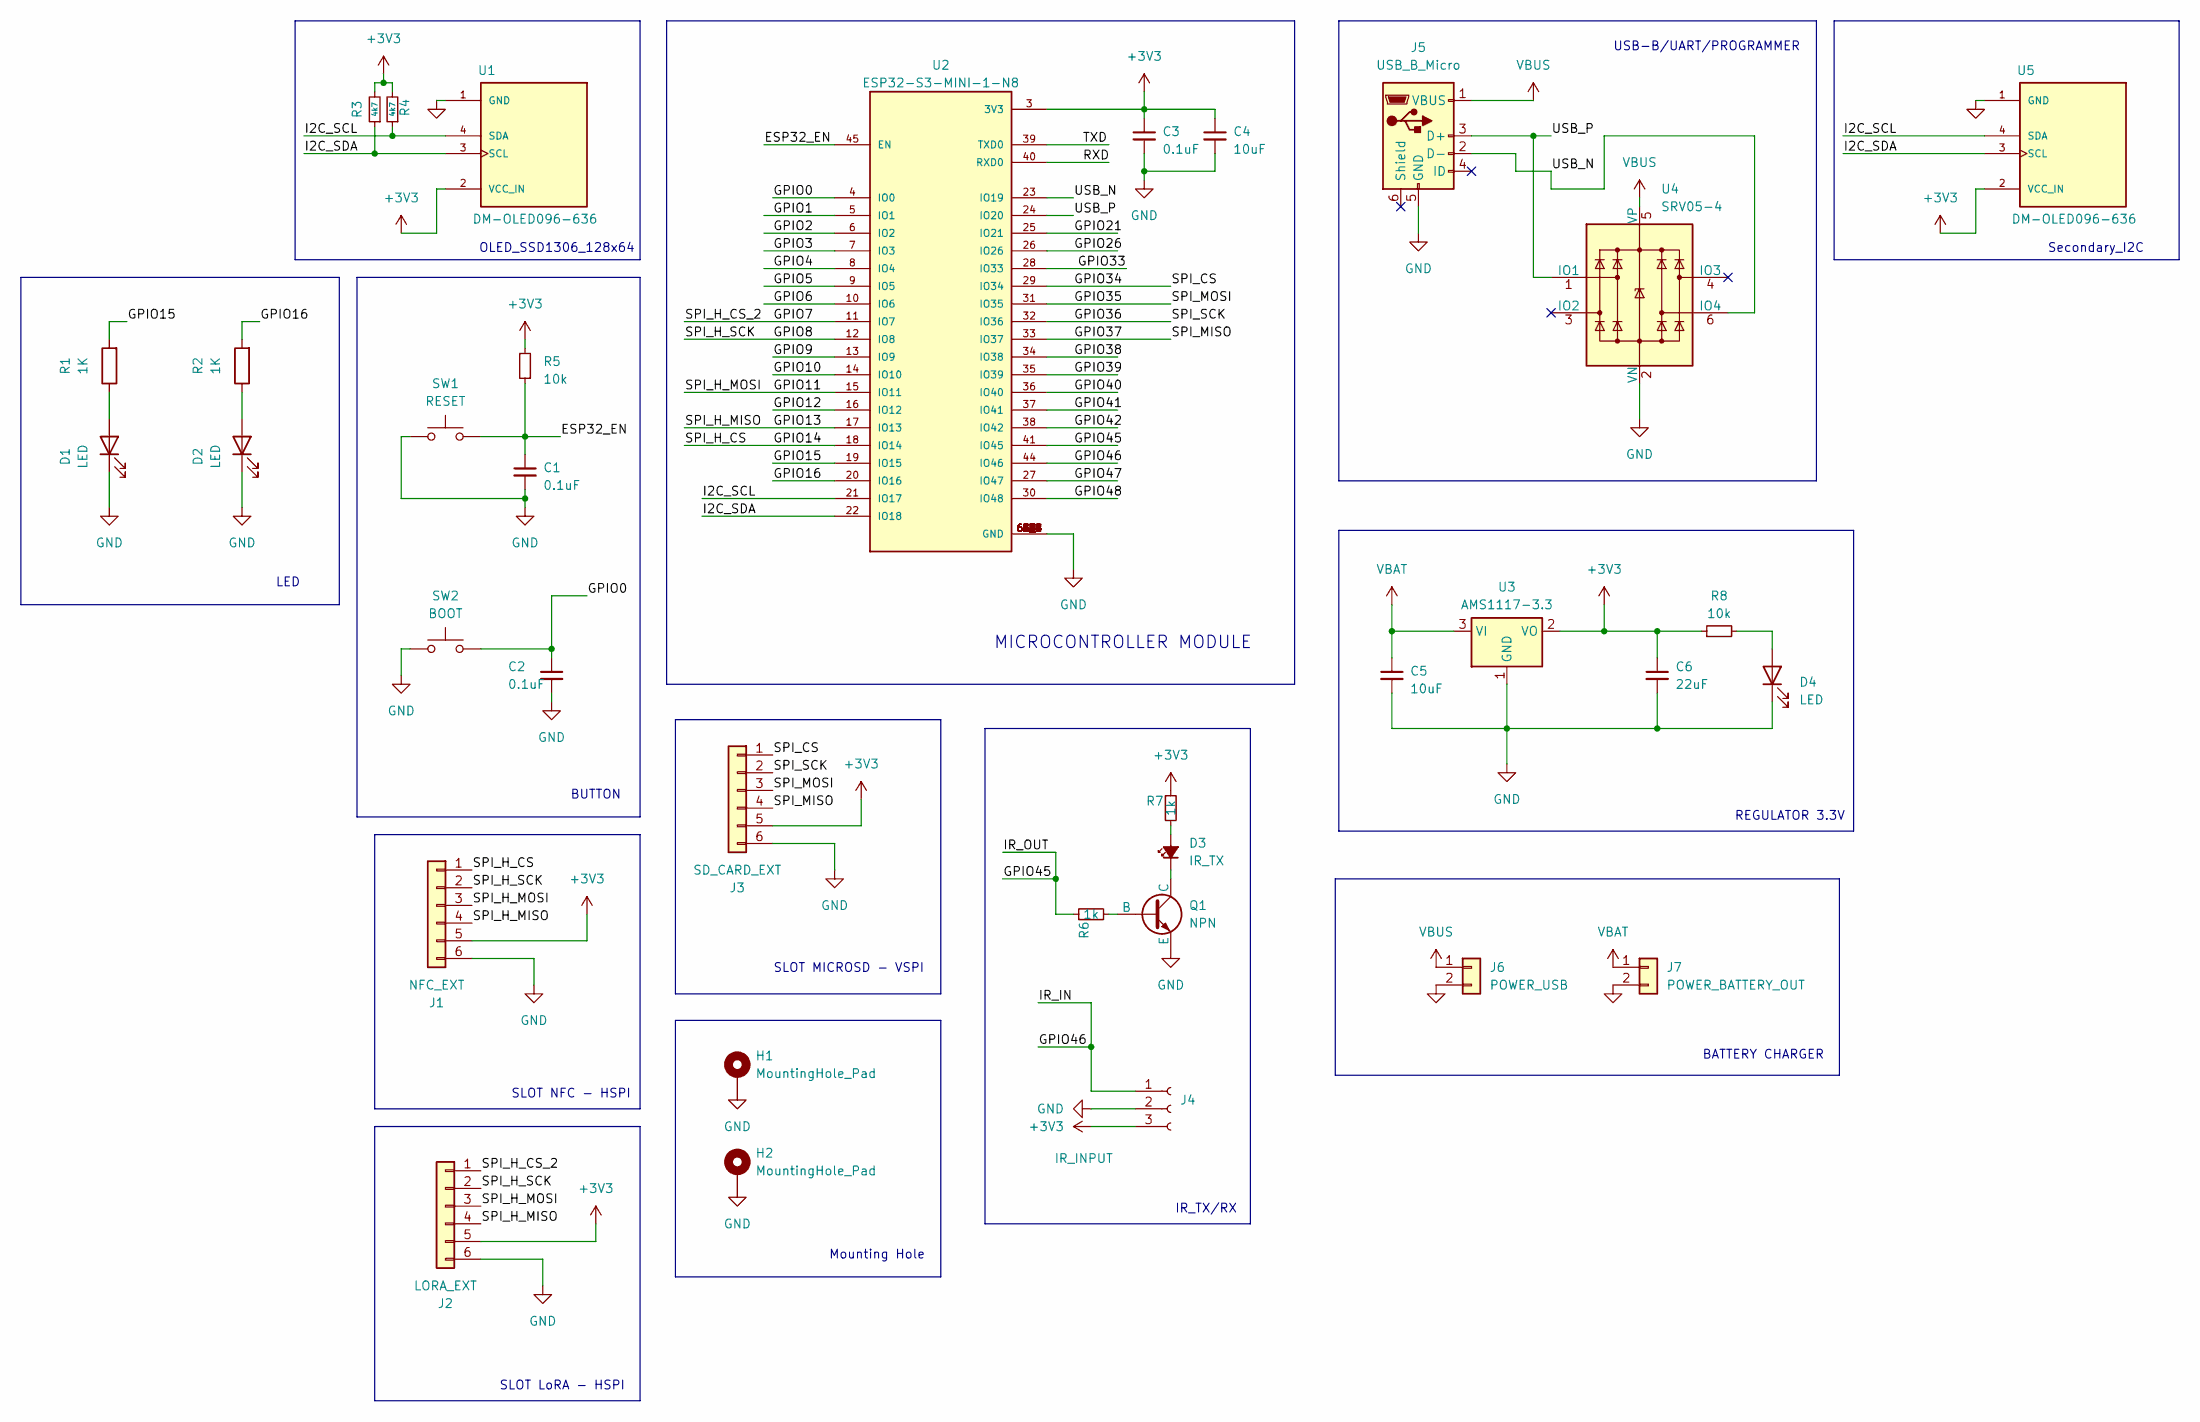
[picture p90: schematic PCB.kicad_sch, SourceForge]

Parts:
C1, C2, C3: 0.1uF; C_0603_1608Metric
C4, C5: 10uF; C_0603_1608Metric
C6: 22uF; C_0603_1608Metric
D1, D2, D4: LED; LED_0603_1608Metric
D3: IR_TX; PinSocket_1x02_P2.54mm_Vertical
H1, H2: MountingHole_Pad; MountingHole_3.2mm_M3_DIN965_Pad
J1: NFC_EXT; PinSocket_1x06_P2.54mm_Vertical
J2: LORA_EXT; PinSocket_1x06_P2.54mm_Vertical
J3: SD_CARD_EXT; PinSocket_1x06_P2.54mm_Vertical
J4: IR_INPUT; PinSocket_1x03_P2.54mm_Vertical
J5: USB_B_Micro; PinSocket_1x05_P2.54mm_Vertical
J6: POWER_USB; PinSocket_1x02_P2.54mm_Vertical
J7: POWER_BATTERY_OUT; PinSocket_1x02_P2.54mm_Vertical
Q1: NPN; SOT-23_Handsoldering
R1, R2: 1K; R_0603_1608Metric
R3, R4: 4k7; R_0603_1608Metric
R5, R8: 10k; R_0603_1608Metric
R6, R7: 1k; R_0603_1608Metric
SW1: RESET; SW_Push_1P1T_NO_CK_KSC6xxJ
SW2: BOOT; SW_Push_1P1T_NO_CK_KSC6xxJ
U1, U5: DM-OLED096-636; PinSocket_1x04_P2.54mm_Vertical; PARTREV 2018-09-10
U2: ESP32-S3-MINI-1-N8; XCVR_ESP32-S3-MINI-1-N8; PARTREV v0.6
U3: AMS1117-3.3; SOT-223-3_TabPin2
U4: SRV05-4; SOT-23-6

Connections:
+3V3: C3.1, C4.1, C6.1, J1.5, J2.5, J3.5, J4.3, R3.2, R4.2, R5.2, R7.1, R8.1, U1.2 (VCC_IN), U2.3 (3V3), U3.2 (VO), U5.2 (VCC_IN)
/ESP32_EN: C1.1, R5.1, SW1.2, U2.45 (EN)
/GPIO0: C2.1, SW2.2, U2.4 (IO0)
/GPIO1: U2.5 (IO1)
/GPIO2: U2.6 (IO2)
/GPIO3: U2.7 (IO3)
/GPIO4: U2.8 (IO4)
/GPIO5: U2.9 (IO5)
/GPIO6: U2.10 (IO6)
/GPIO7: J2.1, U2.11 (IO7)
/GPIO8: J1.2, J2.2, U2.12 (IO8)
/GPIO9: U2.13 (IO9)
/GPIO10: U2.14 (IO10)
/GPIO11: J1.3, J2.3, U2.15 (IO11)
/GPIO12: U2.16 (IO12)
/GPIO13: J1.4, J2.4, U2.17 (IO13)
/GPIO14: J1.1, U2.18 (IO14)
/GPIO15: R1.2, U2.19 (IO15)
/GPIO16: R2.2, U2.20 (IO16)
/GPIO21: U2.25 (IO21)
/GPIO26: U2.26 (IO26)
/GPIO33: U2.28 (IO33)
/GPIO34: J3.1, U2.29 (IO34)
/GPIO35: J3.3, U2.31 (IO35)
/GPIO36: J3.2, U2.32 (IO36)
/GPIO37: J3.4, U2.33 (IO37)
/GPIO38: U2.34 (IO38)
/GPIO39: U2.35 (IO39)
/GPIO40: U2.36 (IO40)
/GPIO41: U2.37 (IO41)
/GPIO42: U2.38 (IO42)
/GPIO45: R6.1, U2.41 (IO45)
/GPIO46: J4.1, U2.44 (IO46)
/GPIO47: U2.27 (IO47)
/GPIO48: U2.30 (IO48)
/I2C_SCL: R4.1, U1.4 (SDA), U2.21 (IO17), U5.4 (SDA)
/I2C_SDA: R3.1, U1.3 (SCL), U2.22 (IO18), U5.3 (SCL)
/RXD: U2.40 (RXD0)
/TXD: U2.39 (TXD0)
/USB_N: J5.2 (D-), U2.23 (IO19), U4.6 (IO4)
/USB_P: J5.3 (D+), U2.24 (IO20), U4.1 (IO1)
GND: C1.2, C2.2, C3.2, C4.2, C5.2, C6.2, D1.1 (K), D2.1 (K), D4.1 (K), H1.1, H2.1, J1.6, J2.6, J3.6, J4.2, J5.5 (GND), J6.2, J7.2, Q1.3 (E), SW1.1, SW2.1, U1.1 (GND), U2.1 (GND), U2.2 (GND), U2.42 (GND), U2.43 (GND), U2.46 (GND), U2.47 (GND), U2.48 (GND), U2.49 (GND), U2.50 (GND), U2.51 (GND), U2.52 (GND), U2.53 (GND), U2.54 (GND), U2.55 (GND), U2.56 (GND), U2.57 (GND), U2.58 (GND), U2.59 (GND), U2.60 (GND), U2.61 (GND), U2.61_1 (GND), U2.61_2 (GND), U2.61_3 (GND), U2.61_4 (GND), U2.61_5 (GND), U2.61_6 (GND), U2.61_7 (GND), U2.61_8 (GND), U2.62 (GND), U2.63 (GND), U2.64 (GND), U2.65 (GND), U3.1 (GND), U4.2 (VN), U5.1 (GND)
unnamed: D1.2 (A), R1.1
unnamed: D2.2 (A), R2.1
unnamed: D3.2 (A), R7.2
unnamed: D3.1 (K), Q1.1 (C)
unnamed: D4.2 (A), R8.2
unnamed: Q1.2 (B), R6.2
VBAT: C5.1, J7.1, U3.3 (VI)
VBUS: J5.1 (VBUS), J6.1, U4.5 (VP)

Notes on the sheet:
USB-B/UART/PROGRAMMER
OLED_SSD1306_128x64
Mounting Hole
LED
SLOT NFC - HSPI
REGULATOR 3.3V
SLOT LoRA - HSPI
Secondary_I2C
BATTERY CHARGER
BUTTON
MICROCONTROLLER MODULE
IR_TX/RX
SLOT MICROSD - VSPI

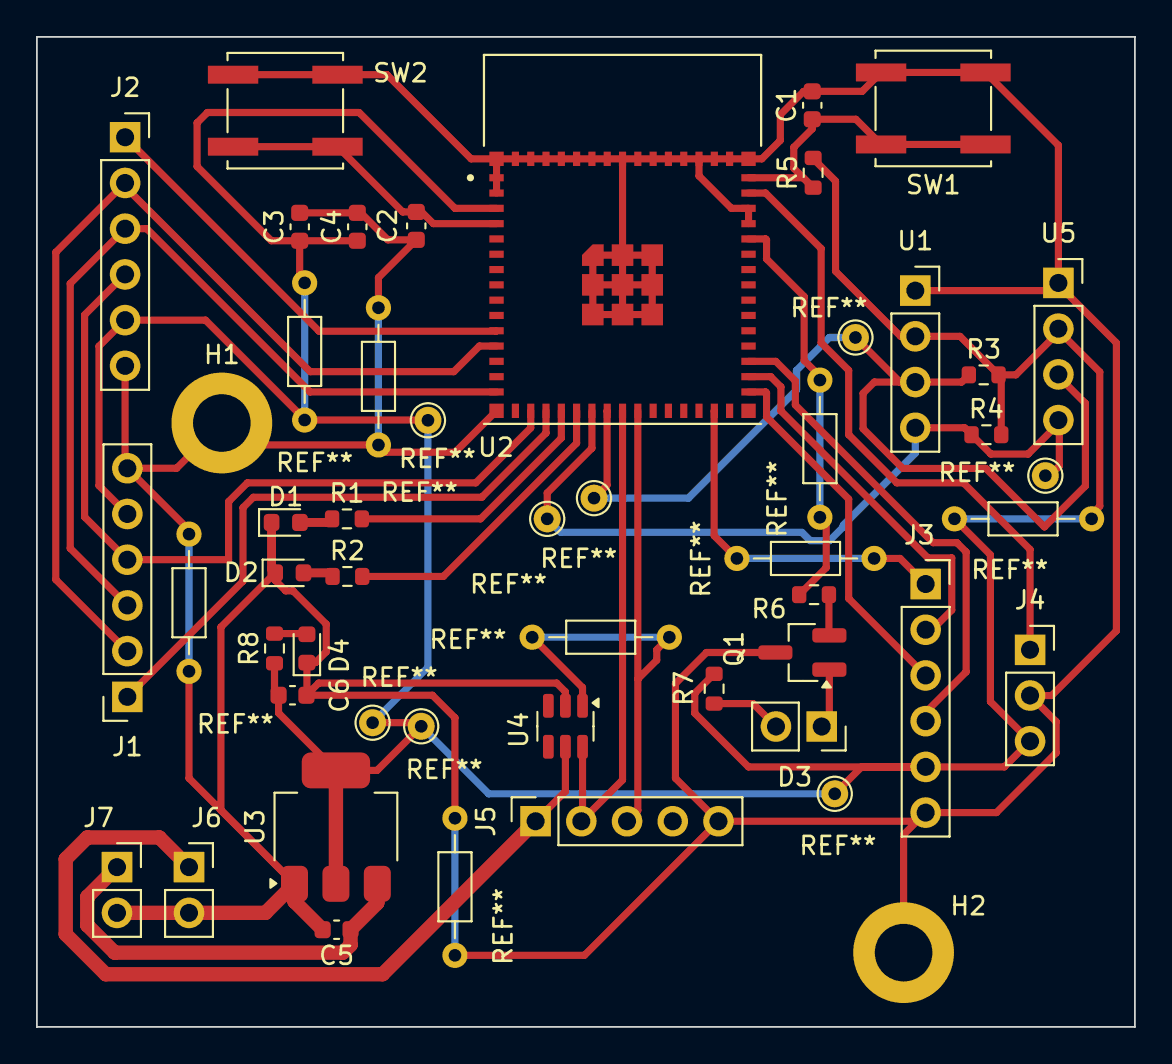
[picture p91: board hardware/SignalForge-V5/PCB/PCB.kicad_pcb from above]

Board: 2 copper layers, 61.0 x 55.0 mm, 35 parts (0 on the bottom side), 29 nets.
