saufik-ramadhan/signalforge/hardware/SignalForge_multipcb/SignalForge_multipcb.kicad_pcb

## KiCad design hardware/SignalForge_multipcb/SignalForge_multipcb.kicad_pcb (2024-11-22)

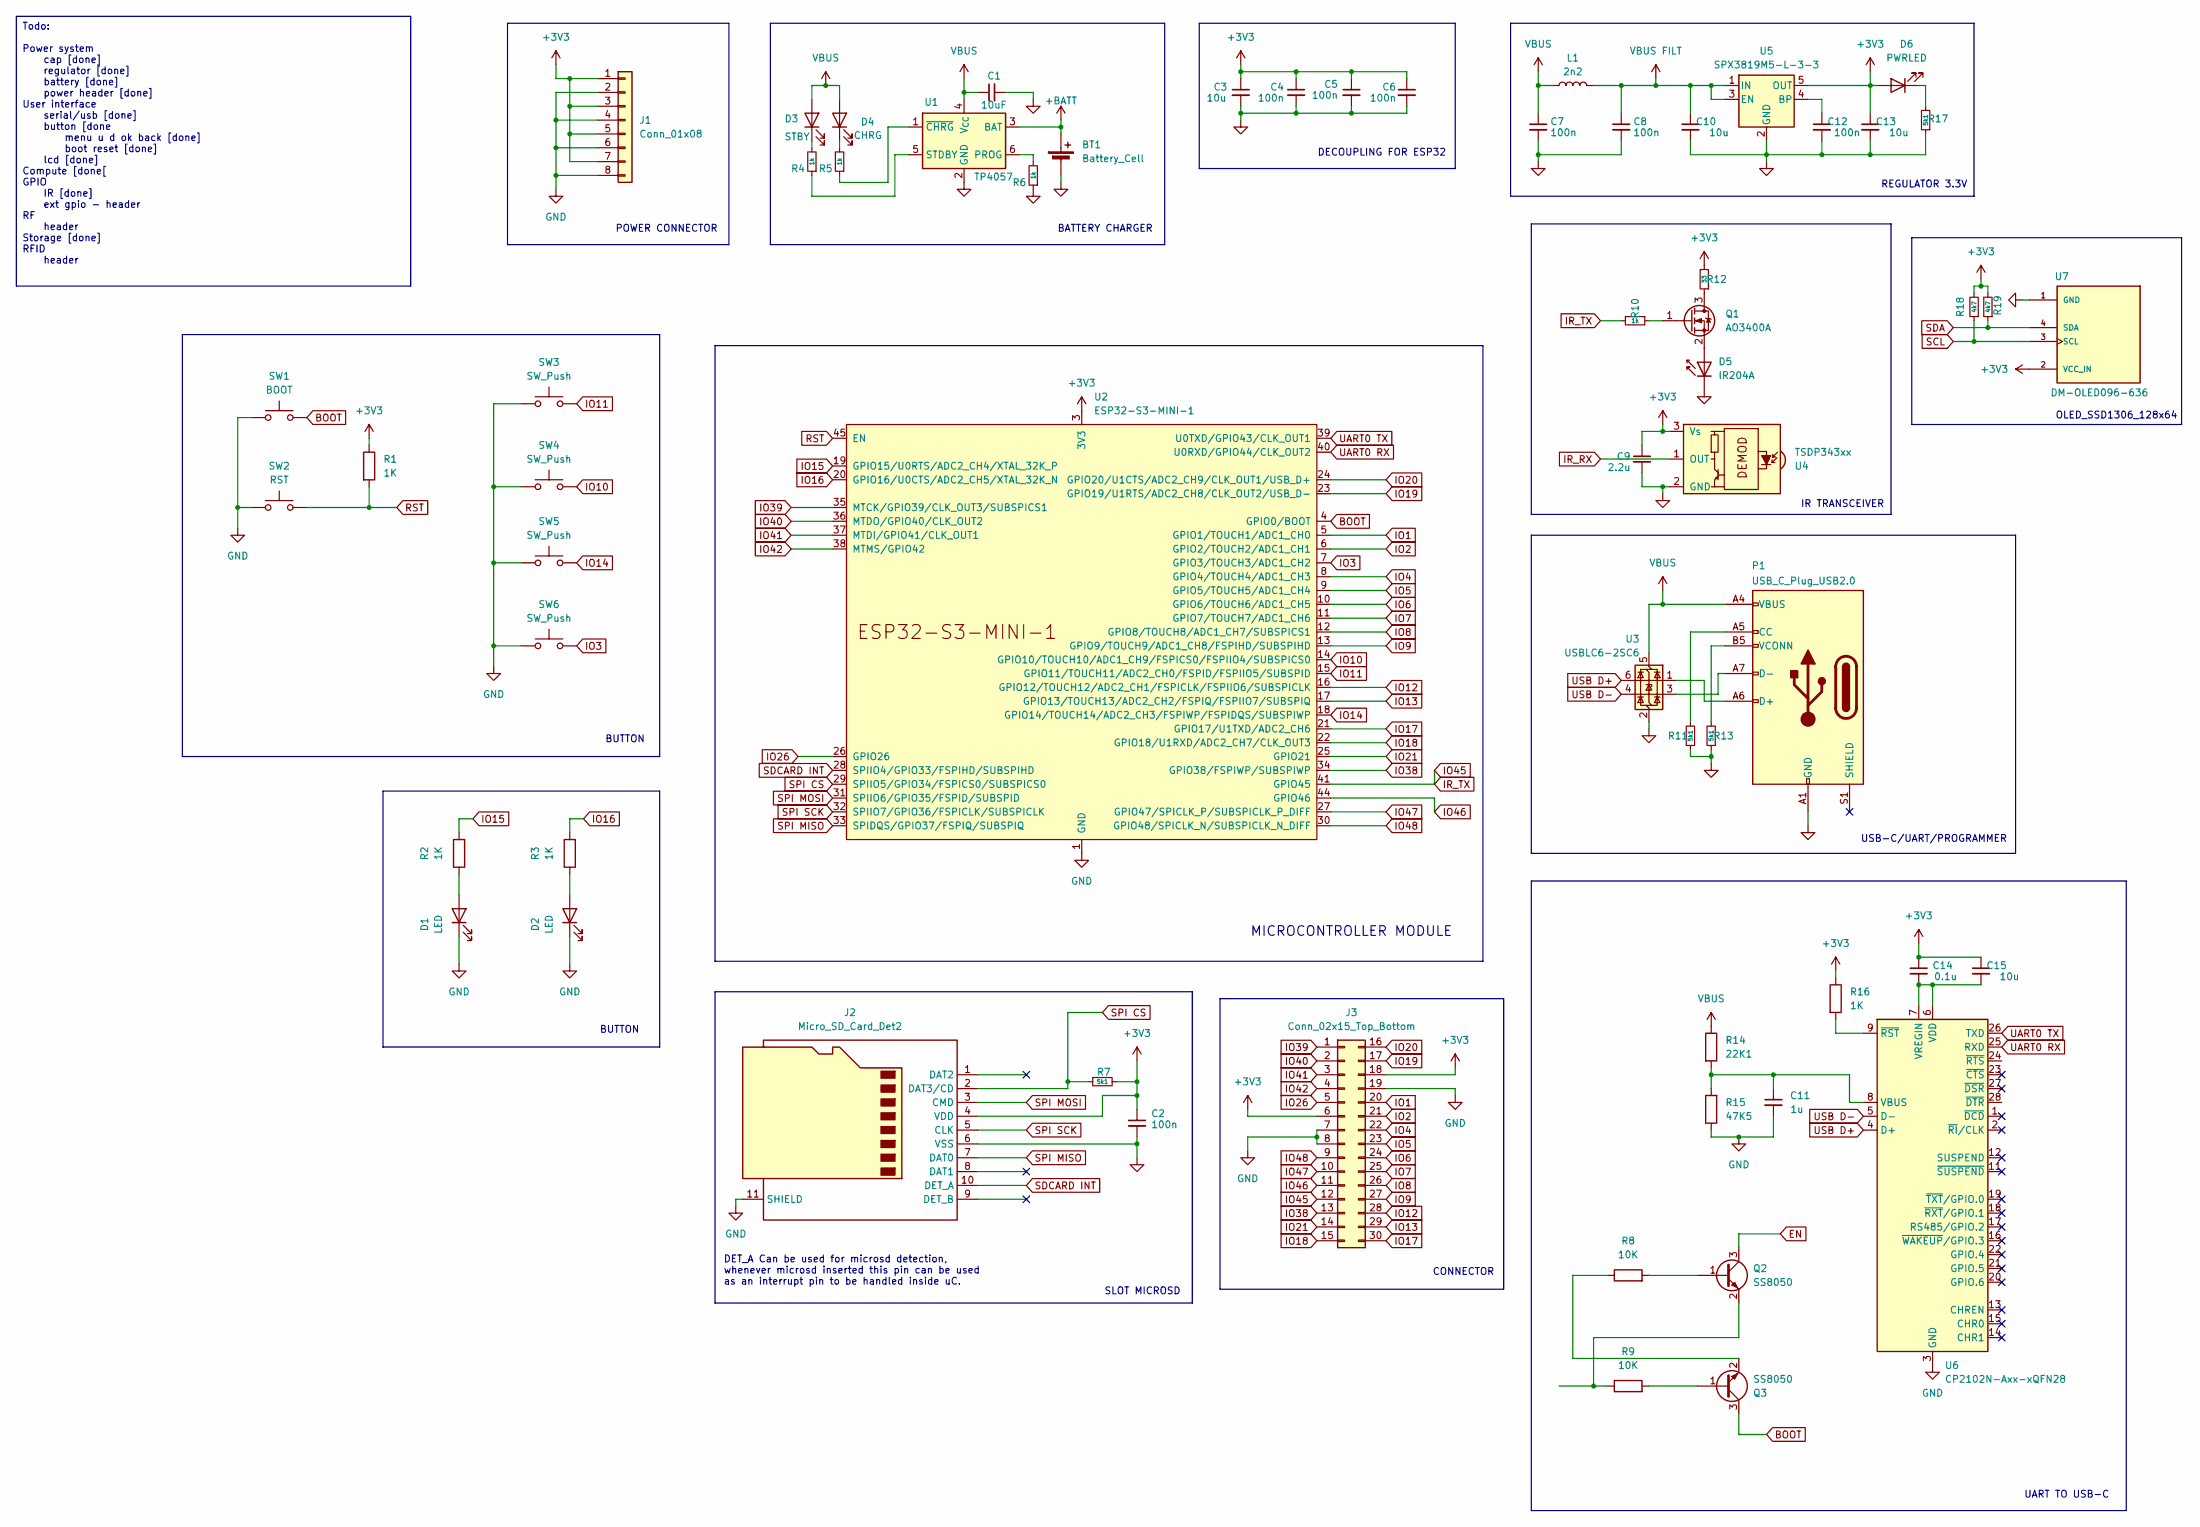
[picture p92: schematic SignalForge_multipcb.kicad_sch]

Parts:
BT1: Battery_Cell; SW_PUSH_6mm
C1: 10uF; C_0402_1005Metric
C2, C4, C5, C6, C7, C8, C12: 100n; C_0402_1005Metric
C3, C10, C13, C15: 10u; R_0402_1005Metric_Pad0.72x0.64mm_HandSolder
C9: 2.2u; C_0402_1005Metric
C11: 1u; C_0402_1005Metric
C14: 0.1u; C_0402_1005Metric
D1, D2: LED; LED_D3.0mm_IRBlack
D3: STBY; LED_D3.0mm_IRBlack
D4: CHRG; LED_D3.0mm_IRBlack
D5: IR204A; LED_D3.0mm_IRBlack
D6: PWRLED; LED_D3.0mm_IRBlack
J1: Conn_01x08; PinHeader_1x08_P2.54mm_Vertical
J2: Micro_SD_Card_Det2; microSD_HC_Hirose_DM3BT-DSF-PEJS
J3: Conn_02x15_Top_Bottom; PinHeader_2x15_P2.54mm_Vertical
L1: 2n2; L_0603_1608Metric
P1: USB_C_Plug_USB2.0; USB_C_Receptacle_GCT_USB4105-xx-A_16P_TopMnt_Horizontal
Q1: AO3400A; TO-247-3_Vertical
Q2, Q3: SS8050; TO-247-3_Vertical
R1, R2, R3, R16: 1K; R_1206_3216Metric
R4, R5, R6, R10: 1k; R_1206_3216Metric
R7, R11, R13, R17: 5k1; R_1206_3216Metric
R8, R9: 10K; R_1206_3216Metric
R12: 33; R_1206_3216Metric
R14: 22K1; R_1206_3216Metric
R15: 47K5; R_1206_3216Metric
R18, R19: 4k7; R_1206_3216Metric
SW1: BOOT; SW_SPST_Omron_B3FS-105xP
SW2: RST; SW_SPST_Omron_B3FS-105xP
SW3, SW4, SW5, SW6: SW_Push; SW_SPST_Omron_B3FS-105xP
U1: TP4057; TSOT-23-6
U2: ESP32-S3-MINI-1
U3: USBLC6-2SC6; SOT-23-6
U4: TSDP343xx; Vishay_MOLD-3Pin
U5: SPX3819M5-L-3-3; SOT-23-5
U6: CP2102N-Axx-xQFN28; QFN-28-1EP_5x5mm_P0.5mm_EP3.35x3.35mm
U7: DM-OLED096-636; PinSocket_1x04_P2.54mm_Vertical; PARTREV 2018-09-10

Connections:
+3V3: C2.1, C3.1, C4.1, C5.1, C6.1, C9.1, C13.1, C14.1, C15.1, D6.2 (A), J1.1, J1.3, J1.5, J1.7, J2.4 (VDD), J3.6, J3.18, R1.1, R7.2, R12.2, R16.1, R18.2, R19.2, U2.3 (3V3), U4.3 (Vs), U5.5 (OUT), U7.2 (VCC_IN)
+BATT: BT1.1 (+), U1.3 (BAT)
BOOT: Q3.3 (C), SW1.2, U2.4 (GPIO0/BOOT)
EN: Q2.3 (C)
GND: BT1.2 (-), C1.2, C2.2, C3.2, C4.2, C5.2, C6.2, C7.2, C8.2, C9.2, C10.2, C11.2, C12.2, C13.2, D1.1 (K), D2.1 (K), D5.1 (K), J1.2, J1.4, J1.6, J1.8, J2.6 (VSS), J2.11 (SHIELD), J3.7, J3.8, J3.19, P1.A1 (GND), P1.A12 (GND), P1.B1 (GND), P1.B12 (GND), R6.1, R11.1, R13.1, R15.1, R17.1, SW1.1, SW2.1, SW3.1, SW4.1, SW5.1, SW6.1, U1.2 (GND), U2.1 (GND), U2.2 (GND), U2.42 (GND), U2.43 (GND), U2.46 (GND), U2.47 (GND), U2.48 (GND), U2.49 (GND), U2.50 (GND), U2.51 (GND), U2.52 (GND), U2.53 (GND), U2.54 (GND), U2.55 (GND), U2.56 (GND), U2.57 (GND), U2.58 (GND), U2.59 (GND), U2.60 (GND), U2.61 (GND), U2.62 (GND), U2.63 (GND), U2.64 (GND), U2.65 (GND), U3.2 (GND), U4.2 (GND), U5.2 (GND), U6.3 (GND), U6.29 (GND), U7.1 (GND)
IO1: J3.20, U2.5 (GPIO1/TOUCH1/ADC1_CH0)
IO2: J3.21, U2.6 (GPIO2/TOUCH2/ADC1_CH1)
IO3: SW6.2, U2.7 (GPIO3/TOUCH3/ADC1_CH2)
IO4: J3.22, U2.8 (GPIO4/TOUCH4/ADC1_CH3)
IO5: J3.23, U2.9 (GPIO5/TOUCH5/ADC1_CH4)
IO6: J3.24, U2.10 (GPIO6/TOUCH6/ADC1_CH5)
IO7: J3.25, U2.11 (GPIO7/TOUCH7/ADC1_CH6)
IO8: J3.26, U2.12 (GPIO8/TOUCH8/ADC1_CH7/SUBSPICS1)
IO9: J3.27, U2.13 (GPIO9/TOUCH9/ADC1_CH8/FSPIHD/SUBSPIHD)
IO10: SW4.2, U2.14 (GPIO10/TOUCH10/ADC1_CH9/FSPICS0/FSPIIO4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)
IO11: SW3.2, U2.15 (GPIO11/TOUCH11/ADC2_CH0/FSPID/FSPIIO5/S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)
IO12: J3.28, U2.16 (GPIO12/TOUCH12/ADC2_CH1/FSPICLK/FSPIIO6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)
IO13: J3.29, U2.17 (GPIO13/TOUCH13/ADC2_CH2/FSPIQ/FSPIIO7/S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)
IO14: SW5.2, U2.18 (GPIO14/TOUCH14/ADC2_CH3/FSPIWP/FSPIDQS/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)
IO15: R2.2, U2.19 (GPIO15/U0RTS/ADC2_CH4/XTAL_32K_P)
IO16: R3.2, U2.20 (GPIO16/U0CTS/ADC2_CH5/XTAL_32K_N)
IO17: J3.30, U2.21 (GPIO17/U1TXD/ADC2_CH6)
IO18: J3.15, U2.22 (GPIO18/U1RXD/ADC2_CH7/CLK_OUT3)
IO19: J3.17, U2.23 (GPIO19/U1RTS/ADC2_CH8/CLK_OUT2/USB_D-)
IO20: J3.16, U2.24 (GPIO20/U1CTS/ADC2_CH9/CLK_OUT1/USB_D+)
IO21: J3.14, U2.25 (GPIO21)
IO26: J3.5, U2.26 (GPIO26)
IO38: J3.13, U2.34 (GPIO38/FSPIWP/SUBSPIWP)
IO39: J3.1, U2.35 (MTCK/GPIO39/CLK_OUT3/SUBSPICS1)
IO40: J3.2, U2.36 (MTDO/GPIO40/CLK_OUT2)
IO41: J3.3, U2.37 (MTDI/GPIO41/CLK_OUT1)
IO42: J3.4, U2.38 (MTMS/GPIO42)
IO45: J3.12, R10.2, U2.41 (GPIO45)
IO46: J3.11, U2.44 (GPIO46)
IO47: J3.10, U2.27 (GPIO47/SPICLK_P/SUBSPICLK_P_DIFF)
IO48: J3.9, U2.30 (GPIO48/SPICLK_N/SUBSPICLK_N_DIFF)
IR_RX: U4.1 (OUT)
unnamed: D1.2 (A), R2.1
unnamed: D2.2 (A), R3.1
unnamed: D3.1 (K), R4.2
unnamed: D4.1 (K), R5.2
unnamed: D5.2 (A), Q1.2 (S)
unnamed: D6.1 (K), R17.2
unnamed: P1.A5 (CC), R11.2
unnamed: P1.A6 (D+), U3.1 (I/O1)
unnamed: P1.A7 (D-), U3.3 (I/O2)
unnamed: P1.B5 (VCONN), R13.2
unnamed: Q1.3 (D), R12.1
unnamed: Q1.1 (G), R10.1
unnamed: Q2.1 (B), R8.2
unnamed: Q2.2 (E), R9.1
unnamed: Q3.1 (B), R9.2
unnamed: Q3.2 (E), R8.1
unnamed: R6.2, U1.6 (PROG)
unnamed: R4.1, U1.5 (STDBY)
unnamed: R5.1, U1.1 (~CHRG)
unnamed: C12.1, U5.4 (BP)
unnamed: C11.1, R14.2, R15.2, U6.8 (VBUS)
unnamed: C14.2, C15.2, U6.6 (VDD), U6.7 (VREGIN)
unnamed: R16.2, U6.9 (~RST)
RST: R1.2, SW2.2, U2.45 (EN)
SCL: R18.1, U7.3 (SCL)
SDA: R19.1, U7.4 (SDA)
SDCARD INT: J2.10 (DET_A), U2.28 (SPIIO4/GPIO33/FSPIHD/SUBSPIHD)
SPI CS: J2.2 (DAT3/CD), R7.1, U2.29 (SPIIO5/GPIO34/FSPICS0/SUBSPICS0)
SPI MISO: J2.7 (DAT0), U2.33 (SPIDQS/GPIO37/FSPIQ/SUBSPIQ)
SPI MOSI: J2.3 (CMD), U2.31 (SPIIO6/GPIO35/FSPID/SUBSPID)
SPI SCK: J2.5 (CLK), U2.32 (SPIIO7/GPIO36/FSPICLK/SUBSPICLK)
UART0 RX: U2.40 (U0RXD/GPIO44/CLK_OUT2), U6.25 (RXD)
UART0 TX: U2.39 (U0TXD/GPIO43/CLK_OUT1), U6.26 (TXD)
USB D+: U3.6 (I/O1), U6.4 (D+)
USB D-: U3.4 (I/O2), U6.5 (D-)
VBUS: C1.1, C7.1, D3.2 (A), D4.2 (A), L1.1, P1.A4 (VBUS), P1.A9 (VBUS), P1.B4 (VBUS), P1.B9 (VBUS), R14.1, U1.4 (V_{CC}), U3.5 (VBUS)
VBUS FILT: C8.1, C10.1, L1.2, U5.1 (IN), U5.3 (EN)

Notes on the sheet:
Todo: Power system cap [done] regulator [done] battery [done] power header [done] User interface serial/usb [done] button [done menu u d ok back [done] boot reset [done] lcd [done] Compute [done[ GPIO IR [done] ext gpio - header RF header Storage [done] RFID header
POWER CONNECTOR
IR TRANSCEIVER
USB-C/UART/PROGRAMMER
CONNECTOR
BUTTON
UART TO USB-C
MICROCONTROLLER MODULE
BATTERY CHARGER
OLED_SSD1306_128x64
DECOUPLING FOR ESP32
REGULATOR 3.3V
DET_A Can be used for microsd detection, whenever microsd inserted this pin can be used as an interrupt pin to be handled inside uC.
SLOT MICROSD

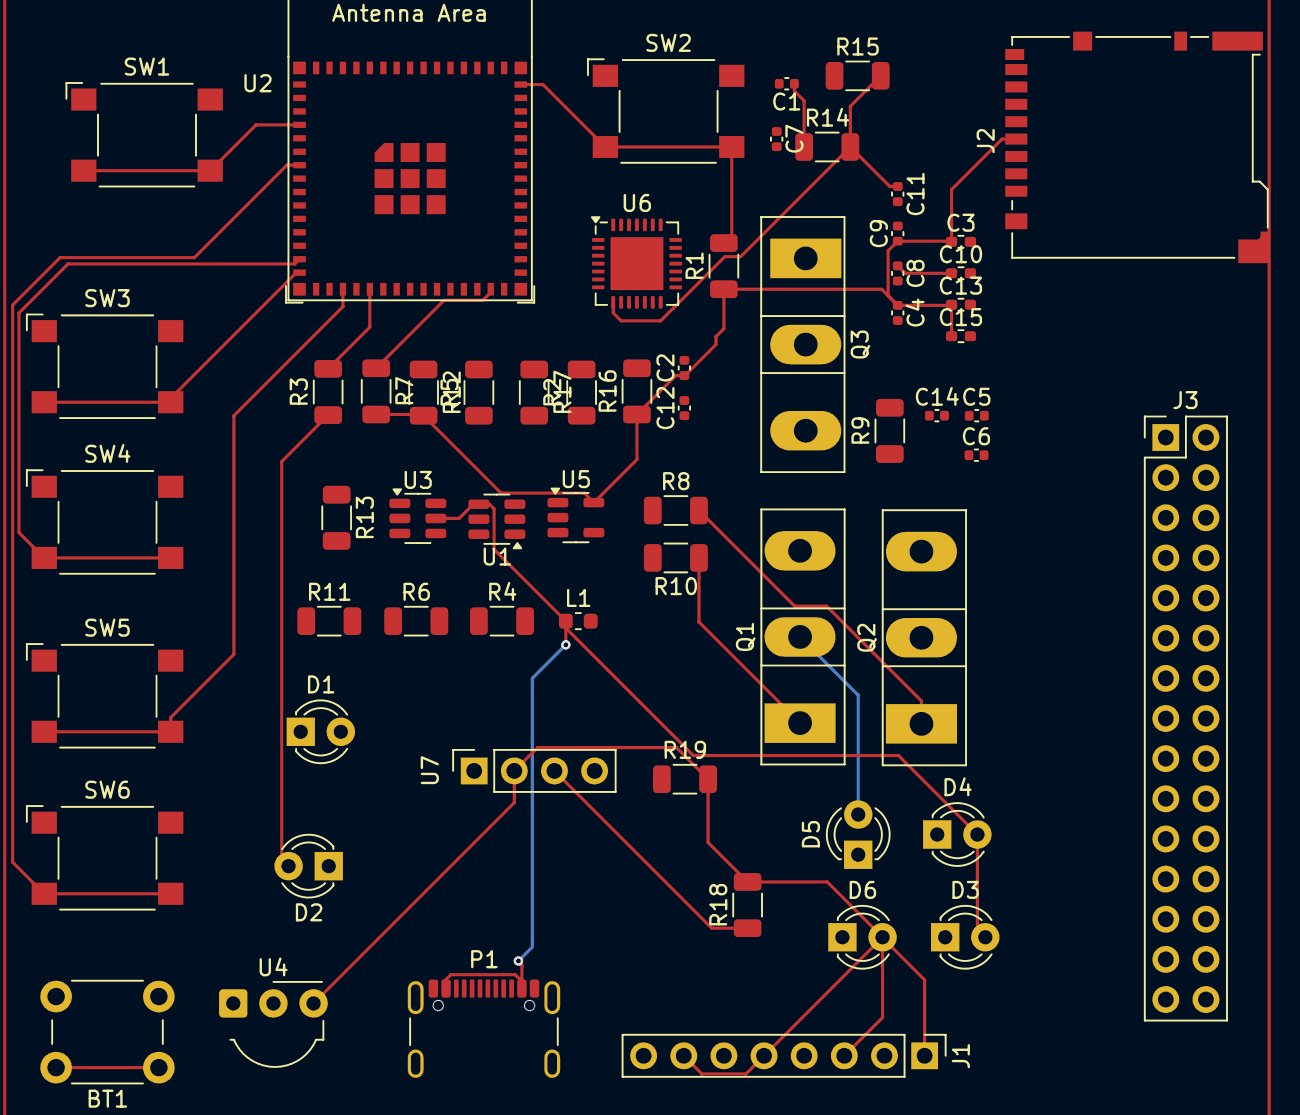
[picture p93: board SignalForge_multipcb.kicad_pcb from above]

Board: 4 copper layers, 62 parts (0 on the bottom side), 72 nets.
