saufik-ramadhan/signalforge/hardware/SignalForge-PCB/PCB/PCB.kicad_pcb

## KiCad design hardware/SignalForge-PCB/PCB/PCB.kicad_pcb (2024-12-01)

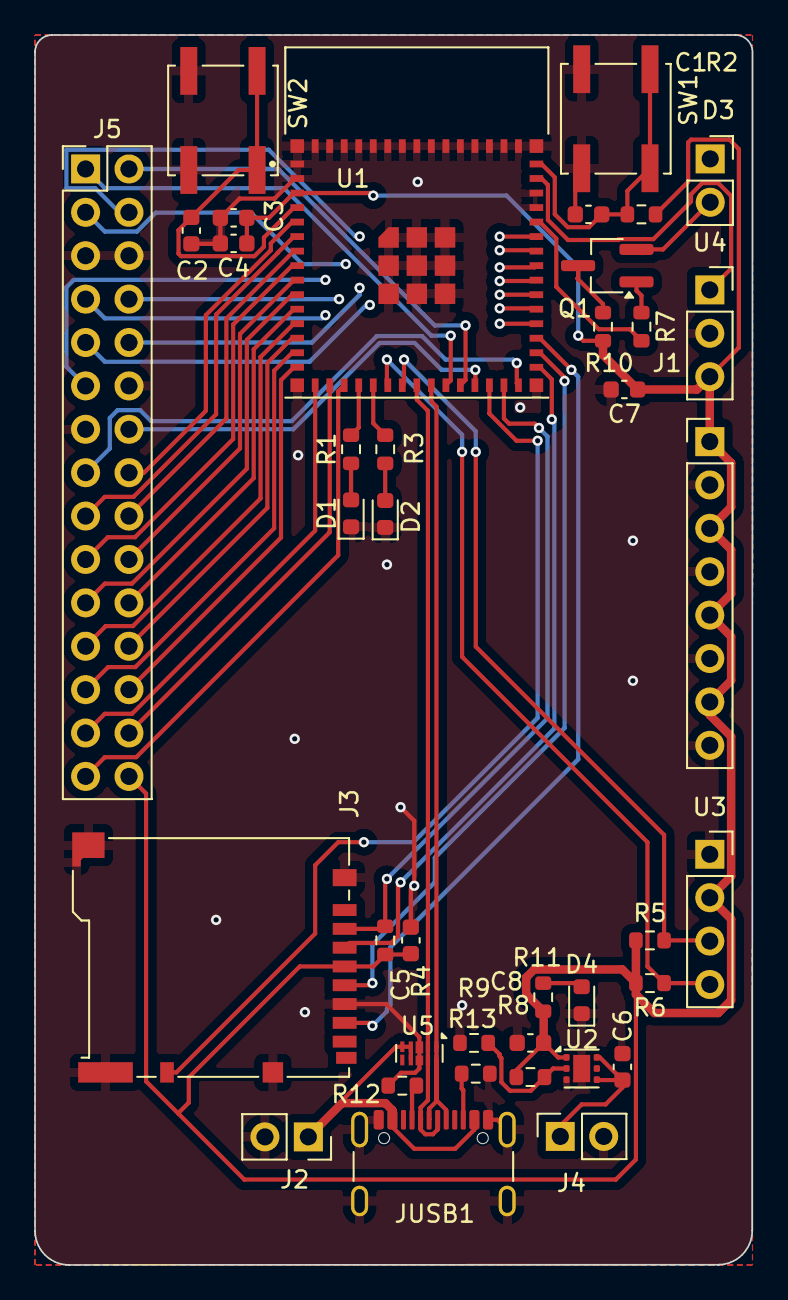
[picture p94: board hardware/SignalForge-PCB/PCB/PCB.kicad_pcb from above]

Board: 4 copper layers, 42.0 x 72.0 mm, 39 parts (0 on the bottom side), 53 nets.

Parts:
C1, C2, C3: 0.1uF; C_0603_1608Metric
C4, C6, C8: 10uF; C_0603_1608Metric
C5: 100n; C_0603_1608Metric
C7: 2.2u; C_0603_1608Metric
D1, D2, D4: LED; LED_0603_1608Metric
D3: IR204A; PinSocket_1x02_P2.54mm_Vertical
J1: Conn_01x08; PinHeader_1x08_P2.54mm_Vertical
J2, J4: Conn_01x02; PinSocket_1x02_P2.54mm_Vertical
J3: Micro_SD_Card_Det2; microSD_HC_Hirose_DM3BT-DSF-PEJS
J5: Conn_02x15_Top_Bottom; PinHeader_2x15_P2.54mm_Vertical
JUSB1: USB_C_Receptacle_USB2.0; USB_C_Receptacle_GCT_USB4105-xx-A_16P_TopMnt_Horizontal
Q1: AO3400A; TSOT-23_HandSoldering
R1, R3: 1K; R_0603_1608Metric
R2: 10k; R_0603_1608Metric
R4: 5k1; R_0603_1608Metric
R5, R6: 4k7; R_0603_1608Metric
R7: 1k; R_0603_1608Metric
R8: 1M; R_0603_1608Metric
R9: 200k; R_0603_1608Metric
R10: 33; R_0603_1608Metric
R11, R12, R13: 5.1k; R_0603_1608Metric
SW1: RESET; SW_Push_1P1T_NO_CK_KSC6xxJ
SW2: BOOT; SW_Push_1P1T_NO_CK_KSC6xxJ
U1: ESP32-S3-MINI-1-N8; XCVR_ESP32-S3-MINI-1-N8
U2: TLV75801PDRV; WSON-6-1EP_2x2mm_P0.65mm_EP1x1.6mm
U3: DM-OLED096-636; PinSocket_1x04_P2.54mm_Vertical
U4: TSDP343xx; PinSocket_1x03_P2.54mm_Vertical
U5: ESD7104MUTAG; Diodes_UDFN-10_1.0x2.5mm_P0.5mm

Connections:
+3V3: C3.1, C4.1, C5.1, C7.1, C8.1, J1.1, J1.3, J1.5, J1.7, J3.4 (VDD), J5.30, R2.2, R4.2, R5.2, R6.2, R8.2, R10.2, R11.1, U1.3 (3V3), U2.1 (OUT), U3.2 (VCC_IN), U4.3 (Vs)
/ESP32_EN: C1.1, R2.1, SW1.2, U1.45 (EN)
/GPIO0: C2.1, SW2.2, U1.4 (IO0)
/GPIO1: J5.16, U1.5 (IO1)
/GPIO2: J5.17, U1.6 (IO2)
/GPIO3: J5.18, U1.7 (IO3)
/GPIO4: J5.19, U1.8 (IO4)
/GPIO5: J5.20, U1.9 (IO5)
/GPIO6: J5.21, U1.10 (IO6)
/GPIO7: J5.22, U1.11 (IO7)
/GPIO8: J5.23, U1.12 (IO8)
/GPIO9: J5.24, U1.13 (IO9)
/GPIO10: J5.25, U1.14 (IO10)
/GPIO11: J5.26, U1.15 (IO11)
/GPIO12: J5.27, U1.16 (IO12)
/GPIO13: J5.28, U1.17 (IO13)
/GPIO14: J5.29, U1.18 (IO14)
/GPIO15: R1.2, U1.19 (IO15)
/GPIO16: R3.2, U1.20 (IO16)
/GPIO21: J5.1, U1.25 (IO21)
/GPIO26: J5.2, U1.26 (IO26)
/GPIO33: J3.10 (DET_A), U1.28 (IO33)
/GPIO34: J3.2 (DAT3/CD), R4.1, U1.29 (IO34)
/GPIO35: J3.3 (CMD), U1.31 (IO35)
/GPIO36: J3.5 (CLK), U1.32 (IO36)
/GPIO37: J3.7 (DAT0), U1.33 (IO37)
/GPIO38: J5.7, U1.34 (IO38)
/GPIO39: J5.8, U1.35 (IO39)
/GPIO40: J5.9, U1.36 (IO40)
/GPIO41: J5.10, U1.37 (IO41)
/GPIO42: J5.11, U1.38 (IO42)
/GPIO45: R7.2, U1.41 (IO45)
/GPIO46: U1.44 (IO46), U4.1 (OUT)
/GPIO47: J5.14, U1.27 (IO47)
/GPIO48: J5.15, U1.30 (IO48)
/I2C_SCL: R6.1, U1.21 (IO17), U3.4 (SDA)
/I2C_SDA: R5.1, U1.22 (IO18), U3.3 (SCL)
/RXD: J5.4, U1.40 (RXD0)
/TXD: J5.3, U1.39 (TXD0)
/USB_N: JUSB1.A7 (D-), JUSB1.B7 (D-), U1.23 (IO19), U5.2, U5.9 (NC)
/USB_P: JUSB1.A6 (D+), JUSB1.B6 (D+), U1.24 (IO20), U5.1, U5.10 (NC)
GND: C1.2, C2.2, C3.2, C4.2, C5.2, C6.2, C7.2, C8.2, D1.1 (K), D2.1 (K), D3.1 (K), D4.1 (K), J1.2, J1.4, J1.6, J1.8, J2.2, J3.6 (VSS), J3.11 (SHIELD), J4.2, J5.5, J5.6, J5.12, J5.13, JUSB1.A1 (GND), JUSB1.A12 (GND), JUSB1.B1 (GND), JUSB1.B12 (GND), JUSB1.S1 (SHIELD), R9.1, R12.2, R13.2, SW1.1, SW2.1, U1.1 (GND), U1.2 (GND), U1.42 (GND), U1.43 (GND), U1.46 (GND), U1.47 (GND), U1.48 (GND), U1.49 (GND), U1.50 (GND), U1.51 (GND), U1.52 (GND), U1.53 (GND), U1.54 (GND), U1.55 (GND), U1.56 (GND), U1.57 (GND), U1.58 (GND), U1.59 (GND), U1.60 (GND), U1.61 (GND), U1.61_1 (GND), U1.61_2 (GND), U1.61_3 (GND), U1.61_4 (GND), U1.61_5 (GND), U1.61_6 (GND), U1.61_7 (GND), U1.61_8 (GND), U1.62 (GND), U1.63 (GND), U1.64 (GND), U1.65 (GND), U2.3 (GND), U2.7 (GND), U3.1 (GND), U4.2 (GND), U5.3 (VSS), U5.8 (VSS)
unnamed: D1.2 (A), R1.1
unnamed: D2.2 (A), R3.1
unnamed: D3.2 (A), Q1.2 (S)
unnamed: D4.2 (A), R11.2
unnamed: JUSB1.A5 (CC1), R12.1
unnamed: JUSB1.B5 (CC2), R13.1
unnamed: Q1.3 (D), R10.1
unnamed: Q1.1 (G), R7.1
unnamed: R8.1, R9.2, U2.2 (FB)
VBAT: C6.1, J4.1, U2.4 (EN), U2.6 (IN)
VBUS: J2.1, JUSB1.A4 (VBUS), JUSB1.A9 (VBUS), JUSB1.B4 (VBUS), JUSB1.B9 (VBUS), U5.4, U5.5, U5.7 (NC)
