saufik-ramadhan/signalforge/software/oled_menu/Main_Menu.ino

const int NUM_ITEMS = 8; // number of items in the list and also the number of screenshots and screenshots with QR codes (other screens)
const int NUM_IR_ITEMS = 5; // IR Emulator child items count
const int NUM_NFC_ITEMS = 5; // NFC Emulator child items count 
const int NUM_WIFI_ITEMS = 5; // WIFI Tools child items count
const int MAX_ITEM_LENGTH = 20; // maximum characters for the item name


// 'icon_3dcube', 16x16px
const unsigned char bitmap_icon_3dcube [] PROGMEM = {
  0x00, 0x00, 0x01, 0x80, 0x07, 0x60, 0x19, 0x18, 0x61, 0x06, 0x51, 0x0a, 0x45, 0xa2, 0x41, 0x02, 
  0x45, 0x22, 0x41, 0x02, 0x45, 0xa2, 0x51, 0x0a, 0x61, 0x06, 0x19, 0x18, 0x07, 0x60, 0x01, 0x80
};
// 'icon_battery', 16x16px
const unsigned char bitmap_icon_battery [] PROGMEM = {
  0x00, 0x00, 0x00, 0x00, 0x00, 0x00, 0x00, 0x00, 0x3f, 0xf8, 0x40, 0x04, 0x5b, 0x66, 0x5b, 0x66, 
  0x5b, 0x66, 0x40, 0x04, 0x3f, 0xf8, 0x00, 0x00, 0x00, 0x00, 0x00, 0x00, 0x00, 0x00, 0x00, 0x00
};
// 'icon_dashboard', 16x16px
const unsigned char bitmap_icon_dashboard [] PROGMEM = {
  0x07, 0xe0, 0x18, 0x18, 0x21, 0x24, 0x50, 0x02, 0x48, 0x0a, 0x84, 0x01, 0x83, 0x81, 0xa2, 0x45, 
  0x82, 0x41, 0x81, 0x81, 0xa0, 0x05, 0x40, 0x02, 0x4b, 0xd2, 0x23, 0xc4, 0x18, 0x18, 0x07, 0xe0
};
// 'icon_fireworks', 16x16px
const unsigned char bitmap_icon_fireworks [] PROGMEM = {
  0x00, 0x00, 0x00, 0x08, 0x00, 0x94, 0x10, 0x08, 0x10, 0x00, 0x6c, 0x00, 0x10, 0x10, 0x10, 0x10, 
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
  0x40, 0x00, 0x00, 0x00, 0x00, 0x00, 0x00, 0x00, 0x00, 0x00, 0x00, 0x00, 0x00, 0x00, 0x00, 0x30, 
  0x40, 0x00, 0x00, 0x00, 0x00, 0x00, 0x00, 0x00, 0x00, 0x00, 0x00, 0x00, 0x00, 0x00, 0x00, 0x30, 
  0x40, 0x00, 0x00, 0x00, 0x00, 0x00, 0x00, 0x00, 0x00, 0x00, 0x00, 0x00, 0x00, 0x00, 0x00, 0x30, 
  0x40, 0x00, 0x00, 0x00, 0x00, 0x00, 0x00, 0x00, 0x00, 0x00, 0x00, 0x00, 0x00, 0x00, 0x00, 0x30, 
  0x40, 0x00, 0x00, 0x00, 0x00, 0x00, 0x00, 0x00, 0x00, 0x00, 0x00, 0x00, 0x00, 0x00, 0x00, 0x30, 
  0x3f, 0xff, 0xff, 0xff, 0xff, 0xff, 0xff, 0xff, 0xff, 0xff, 0xff, 0xff, 0xff, 0xff, 0xff, 0xe0, 
  0x1f, 0xff, 0xff, 0xff, 0xff, 0xff, 0xff, 0xff, 0xff, 0xff, 0xff, 0xff, 0xff, 0xff, 0xff, 0xc0
};

char menu_items [NUM_ITEMS] [MAX_ITEM_LENGTH] = {  // array with item names
  { "IR Emulator" }, 
  { "NFC Emulator" }, 
  { "WiFi Tools" }, 
  { "Fireworks" }, 
  { "GPS Speed" }, 
  { "Big Knob" },   
  { "Park Sensor" }, 
  { "Turbo Gauge" }
};

  char ir_menu_items [3] [MAX_ITEM_LENGTH] = {
    { "Read IR Signal" },
    { "Write IR Signal" },
    { "List Saved IR" }
  };

  char nfc_menu_items [3] [MAX_ITEM_LENGTH] = {
    { "Read NFC Card" },
    { "Write NFC Card" },
    { "List Saved NFC" }
  };

  char wifi_menu_items [3] [MAX_ITEM_LENGTH] = {
    { "Wifi Listening" },
    { "Wifi Deauth" },
    { "Wifi Clone" }
  };
// note - when changing the order of items above, make sure the other arrays referencing bitmaps
// also have the same order, for example array "bitmap_icons" for icons, and other arrays for screenshots and QR codes

void handleMenu() {
  // when pin 13 is LOW (DEMO_PIN), enable demo mode
  // this could be done either by using a switch
  // or simply by connecting the wire between pin 13 and GND 
  // (those pins are next to each other)
  if (digitalRead(DEMO_PIN) == LOW) {
    demo_mode = 1; // enable demo mode  
  }
  else  {
    demo_mode = 0; // disable demo mode
  }
    

  if (demo_mode == 1) { // when demo mode is active, automatically switch between all the screens and menu items
    demo_mode_delay++; // increase demo mode delay
    if (demo_mode_delay > 15) { // after some time, switch to another screen - change this value to make it slower/faster
      demo_mode_delay = 0;
      demo_mode_state++; // increase counter
      if (demo_mode_state >= NUM_ITEMS*3) {demo_mode_state=0;} // jump back to the first screen
    }
  
    if (demo_mode_state % 3 == 0) {current_screen = 0; item_selected = demo_mode_state/3; } // menu screen
    else if (demo_mode_state % 3 == 1) {current_screen = 1; item_selected = demo_mode_state/3;} // screenshots screen
    else if (demo_mode_state % 3 == 2) {current_screen = 2; item_selected = demo_mode_state/3;} // qr codes screen

  } // end demo mode section


  if (current_screen == 0) { // MENU SCREEN
      // up and down buttons only work for the menu screen
      if ((digitalRead(BUTTON_UP_PIN) == LOW) && (button_up_clicked == 0)) { // up button clicked - jump to previous menu item
        item_selected = item_selected - 1; // select previous item
        button_up_clicked = 1; // set button to clicked to only perform the action once
        if (item_selected < 0) { // if first item was selected, jump to last item
          item_selected = NUM_ITEMS-1;
        }
      }
      else if ((digitalRead(BUTTON_DOWN_PIN) == LOW) && (button_down_clicked == 0)) { // down button clicked - jump to next menu item
        item_selected = item_selected + 1; // select next item
        button_down_clicked = 1; // set button to clicked to only perform the action once
        if (item_selected >= NUM_ITEMS) { // last item was selected, jump to first menu item
          item_selected = 0;
          }
      } 

      if ((digitalRead(BUTTON_UP_PIN) == HIGH) && (button_up_clicked == 1)) { // unclick 
        button_up_clicked = 0;
      }
      if ((digitalRead(BUTTON_DOWN_PIN) == HIGH) && (button_down_clicked == 1)) { // unclick
        button_down_clicked = 0;
      }

  } else if (current_screen == 1) { // CHILD MENU SCREEN
      // up and down buttons only work for the menu screen
      if ((digitalRead(BUTTON_UP_PIN) == LOW) && (button_up_clicked == 0)) { // up button clicked - jump to previous menu item
        item_selected_child = item_selected_child - 1; // select previous item
        button_up_clicked = 1; // set button to clicked to only perform the action once
        if (item_selected_child < 0) { // if first item was selected, jump to last item
          item_selected_child = child_menu_size-1;
        }
      }
      else if ((digitalRead(BUTTON_DOWN_PIN) == LOW) && (button_down_clicked == 0)) { // down button clicked - jump to next menu item
        item_selected_child = item_selected_child + 1; // select next item
        button_down_clicked = 1; // set button to clicked to only perform the action once
        if (item_selected_child >= child_menu_size) { // last item was selected, jump to first menu item
          item_selected_child = 0;
        }
      } 

      if ((digitalRead(BUTTON_UP_PIN) == HIGH) && (button_up_clicked == 1)) { // unclick 
        button_up_clicked = 0;
      }
      if ((digitalRead(BUTTON_DOWN_PIN) == HIGH) && (button_down_clicked == 1)) { // unclick
        button_down_clicked = 0;
      }
  }


  if ((digitalRead(BUTTON_SELECT_PIN) == LOW) && (button_select_clicked == 0)) { // select button clicked, jump between screens
     button_select_clicked = 1; // set button to clicked to only perform the action once
     if (current_screen == 0) {current_screen = 1;} // menu items screen --> screenshots screen
     else if (current_screen == 1) {current_screen = 2;} // screenshots screen --> qr codes screen
     else {current_screen = 0;} // qr codes screen --> menu items screen
  }
  if ((digitalRead(BUTTON_SELECT_PIN) == HIGH) && (button_select_clicked == 1)) { // unclick 
    button_select_clicked = 0;
  }

  // set correct values for the previous and next items
  item_sel_previous = item_selected - 1;
  if (item_sel_previous < 0) {item_sel_previous = NUM_ITEMS - 1;} // previous item would be below first = make it the last
  item_sel_next = item_selected + 1;  
  if (item_sel_next >= NUM_ITEMS) {item_sel_next = 0;} // next item would be after last = make it the first

  // set correct values for the previous and next items
  item_sel_previous_child = item_selected_child - 1;
  if (item_sel_previous_child < 0) {item_sel_previous_child = child_menu_size - 1;} // previous item would be below first = make it the last
  item_sel_next_child = item_selected_child + 1;  
  if (item_sel_next_child >= child_menu_size) {item_sel_next_child = 0;} // next item would be after last = make it the first


  u8g.firstPage(); // required for page drawing mode for u8g library
  do {

    if (current_screen == 0) { // MENU SCREEN

      // selected item background
      u8g.drawBitmap(0, 22, 128/8, 21, bitmap_item_sel_outline);

      // draw previous item as icon + label
      u8g.setFont(u8g_font_7x14);
      u8g.drawStr(25, 15, menu_items[item_sel_previous]); 
      u8g.drawBitmap( 4, 2, 16/8, 16, bitmap_icons[item_sel_previous]);          

      // draw selected item as icon + label in bold font
      u8g.setFont(u8g_font_7x14B);    
      u8g.drawStr(25, 15+20+2, menu_items[item_selected]);   
      u8g.drawBitmap( 4, 24, 16/8, 16, bitmap_icons[item_selected]);     

      // draw next item as icon + label
      u8g.setFont(u8g_font_7x14);     
      u8g.drawStr(25, 15+20+20+2+2, menu_items[item_sel_next]);   
      u8g.drawBitmap( 4, 46, 16/8, 16, bitmap_icons[item_sel_next]);  

      // draw scrollbar background
      // u8g.drawBitmap(128-7, 0, 8/8, 64, bitmap_scrollbar_background);

      // draw scrollbar handle
      u8g.drawBox(125, 64/NUM_ITEMS * item_selected, 3, 64/NUM_ITEMS); 

      // draw upir logo
      // u8g.drawBitmap(128-16-4, 64-4, 16/8, 4, upir_logo);               

    } 
    else if (current_screen == 1) { // SCREENSHOTS SCREEN
      char * prevMenu, * currMenu, * nextMenu;
      if(item_selected == 0) {
        prevMenu = ir_menu_items[item_sel_previous_child];
        currMenu = ir_menu_items[item_selected_child];
        nextMenu = ir_menu_items[item_sel_next_child];
        child_menu_size = sizeof(ir_menu_items);
      } else if(item_selected == 1) {
        prevMenu = nfc_menu_items[item_sel_previous_child];
        currMenu = nfc_menu_items[item_selected_child];
        nextMenu = nfc_menu_items[item_sel_next_child];
        child_menu_size = sizeof(nfc_menu_items);
      } else if(item_selected == 2) {
        prevMenu = wifi_menu_items[item_sel_previous_child];
        currMenu = wifi_menu_items[item_selected_child];
        nextMenu = wifi_menu_items[item_sel_next_child];
        child_menu_size = sizeof(wifi_menu_items);
      }

      // selected item background
      u8g.drawBitmap(0, 22, 128/8, 21, bitmap_item_sel_outline);

      // draw previous item as icon + label
      u8g.setFont(u8g_font_7x14);
      u8g.drawStr(25, 15, prevMenu);
      u8g.drawBitmap( 4, 2, 16/8, 16, bitmap_icons[item_selected]);          

      // draw selected item as icon + label in bold font
      u8g.setFont(u8g_font_7x14B);    
      u8g.drawStr(25, 15+20+2, currMenu);
      u8g.drawBitmap( 4, 24, 16/8, 16, bitmap_icons[item_selected]);     

      // draw next item as icon + label
      u8g.setFont(u8g_font_7x14);     
      u8g.drawStr(25, 15+20+20+2+2, nextMenu);
      u8g.drawBitmap( 4, 46, 16/8, 16, bitmap_icons[item_selected]);  

      // draw scrollbar background
      // u8g.drawBitmap(128-7, 0, 8/8, 64, bitmap_scrollbar_background);

      // draw scrollbar handle
      // u8g.drawBox(125, 64/NUM_ITEMS * item_selected, 3, 64/NUM_ITEMS); 
    }
    else if (current_screen == 2) { // QR SCREEN
        u8g.drawBitmap( 0, 0, 128/8, 64, bitmap_qr_codes[item_selected]); // draw qr code screenshot
    }   

  } while ( u8g.nextPage() ); // required for page drawing mode with u8g library
}
