saufik-ramadhan/signalforge/software/ir_transceiver/ir_emulator/ir_emulator.ino

#include <IRremote.hpp>
#define IR_RECEIVE_PIN 4

void setup()
{
  Serial.begin(115200); // // Establish serial communication
  IrReceiver.begin(IR_RECEIVE_PIN, ENABLE_LED_FEEDBACK); // Start the receiver
  if(!display.begin(SSD1306_SWITCHCAPVCC, SCREEN_ADDRESS)) {
    Serial.println(F("SSD1306 allocation failed"));
    for(;;); // Don't proceed, loop forever
  }
  display.display();
  delay(2000);
  display.clearDisplay();
  display.drawPixel(10, 10, SSD1306_WHITE);
  display.display();
  delay(2000);
}

void loop() {
  if (IrReceiver.decode()) {
      Serial.println(IrReceiver.decodedIRData.decodedRawData, HEX); // Print "old" raw data
      IrReceiver.printIRResultShort(&Serial); // Print complete received data in one line
      IrReceiver.printIRSendUsage(&Serial);   // Print the statement required to send this data
      IrReceiver.resume(); // Enable receiving of the next value
  }
  serialInterfaceListen();
}
