saufik-ramadhan/signalforge/src/sensors_bin/firmware_integrated/Menu_List.h

// MENU ENUMS
#define MENU_IR_MODULE            1
#define MENU_IR_MODULE_LENGTH     3
#define MENU_IR_MODULE__READ      11
#define MENU_IR_MODULE__WRITE     12
#define MENU_IR_MODULE__LIST      13

#define MENU_NFC_MODULE           2
#define MENU_WIFI_MODULE          3
#define MENU_SD_MODULE            4
#define MENU_BLUETOOTH_MODULE     5
#define MENU_EXIT                 6
#define MENU_CONFIRMATION         7
