saufik-ramadhan/signalforge/software/Python/scroll.py

import tkinter as tk
from tkinter import ttk
from tkinter.messagebox import showinfo

# create the root window
root = tk.Tk()

root.title('Listbox')


# create a list box
langs = ('Java', 'C#', 'C', 'C++', 'Python',
         'Go', 'JavaScript', 'PHP', 'Swift')

var = tk.Variable(value=langs)

listbox = tk.Listbox(
    root,
    listvariable=var,
    height=6,
    selectmode=tk.SINGLE)


listbox.pack(expand=True, fill=tk.BOTH, side=tk.LEFT)
listbox.activate(0)

# link a scrollbar to a list
scrollbar = ttk.Scrollbar(
    root,
    orient=tk.VERTICAL,
    command=listbox.yview
)

listbox['yscrollcommand'] = scrollbar.set

scrollbar.pack(side=tk.LEFT, expand=True, fill=tk.Y)


def items_selected(event):
    # get selected indices
    selected_indices = listbox.curselection()
    # get selected items
    selected_langs = ",".join([listbox.get(i) for i in selected_indices])
    msg = f'You selected: {selected_langs} {selected_indices}'

    showinfo(title='Information', message=msg)
    listbox.activate(0)


listbox.bind('<<ListboxSelect>>', items_selected)

root.mainloop()
