saufik-ramadhan/signalforge/src/demo1/serial_menu/serial_menu.ino

// Library imports have been removed as per your request

// Wi-Fi settings (placeholders)
const char* ssid = "";
const char* password = "";

// RFID settings (placeholders)
// #define PN532_SDA 21
// #define PN532_SCL 22
// Adafruit_PN532 nfc(PN532_SDA, PN532_SCL);

// BLE settings (placeholders)
// BLEScan* pBLEScan;
int scanTime = 5; // BLE scan time in seconds

void setup() {
  Serial.begin(115200);
  while (!Serial) delay(10);
  Serial.println("ESP32 Menu Example");

  // Initialize Wi-Fi (placeholder)
  // WiFi.mode(WIFI_STA);
  // WiFi.disconnect();

  // Initialize BLE (placeholder)
  // BLEDevice::init("");

  // Initialize RFID (placeholder)
  // nfc.begin();
  // uint32_t versiondata = nfc.getFirmwareVersion();
  // if (!versiondata) {
  //   Serial.println("Didn't find PN532 board");
  //   // Continue without halting
  // } else {
  //   nfc.SAMConfig();
  // }

  // Print the menu
  printMenu();
}

void loop() {
  if (Serial.available()) {
    char option = Serial.read();
    Serial.print("You selected option: ");
    Serial.println(option);

    switch (option) {
      case '1':
        wifiScanAndConnect();
        break;
      case '2':
        bluetoothScan();
        break;
      case '3':
        readRFID();
        break;
      case '4':
        writeRFID();
        break;
      default:
        Serial.println("Invalid option. Please select 1-4.");
    }

    printMenu();
  }
}

void printMenu() {
  Serial.println("\nSelect an option:");
  Serial.println("1: Wi-Fi scanning and connecting");
  Serial.println("2: Bluetooth device scanning");
  Serial.println("3: Read RFID data");
  Serial.println("4: Write RFID data");
  Serial.print("Enter your choice: ");
}

void wifiScanAndConnect() {
  Serial.println("Wi-Fi scanning and connecting functionality is not implemented.");
}

void bluetoothScan() {
  Serial.println("Bluetooth device scanning functionality is not implemented.");
}

void readRFID() {
  Serial.println("Reading RFID data functionality is not implemented.");
}

void writeRFID() {
  Serial.println("Writing RFID data functionality is not implemented.");
}

String readSerialString() {
  String inputString = "";
  while (true) {
    while (Serial.available()) {
      char c = Serial.read();
      if (c == '\n' || c == '\r') {
        return inputString;
      } else {
        inputString += c;
      }
    }
    delay(10);
  }
}
