saufik-ramadhan/signalforge/(commit log)

2024-10-08 add proposal (undone)
    [Rincian Biaya.xlsx]
2024-10-27 feat: hw schematic (undone)
    [SignalForge.kicad_pcb, SignalForge.kicad_sch, SignalForgeS3.kicad_pcb, SignalForgeS3.kicad_sch]
2024-11-04 sw: sdcard, camera
    [SignalForge.kicad_sch]
2024-11-07 feat: ir, nfc, battery charger
    [SignalForge.kicad_sch]
2024-11-07 feat: sw IR Remote based on IRRemote Arduino
2024-11-21 fix: menu child oled, testing IR send-receive with known protocols
    [IR_PinDefinitions.h, IR_Receiver.ino, IR_Transmitter.ino, Main_Menu.ino, Menu_List.h, firmware_integrated.ino]
2024-11-22 update skematik
    [SignalForge_multipcb.kicad_pcb, SignalForge_multipcb.kicad_sch]
2024-12-01 add new design
    [BOM.csv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]
2024-12-30 fix: sd card firmware updater
    [FW_SD_Updater.ino, firmware_integrated.ino]
2025-01-01 add new iteration
    [PCB.csv, PCB.kicad_pcb, PCB.kicad_sch, PCB.xlsx, bom.csv, designators.csv, positions.csv]
2025-01-02 add acrilic casing
    [MultiJoin_preview_parts1.FCStd, export_shape1.FCStd]
2025-01-02 fix: pin definition
2025-01-05 a lot of stuff
    [MultiJoin_preview_parts1.FCStd, export_shape2.FCStd, export_shape3.dxf]
2025-01-05 new casing
    [Casing_3DPrint.FCStd, MultiJoin_preview_parts1.FCStd]
2025-01-05 new casing - step
    [Casing_3DPrint-Body001.step, Casing_3DPrint-Body002.step, Casing_3DPrint.FCStd]
2025-01-06 update documents
    [Casing_3DPrint.FCStd, MultiJoin_preview_parts1.FCStd]
2025-01-23 new 3d design
    [version3-Body.step, version3-Body002.step, version3.FCStd]
2025-01-23 update steps
    [version3-2-Body002.step, version3-2.FCStd, version3-Body.step, version3-Body002.step, version3.FCStd]
2025-01-24 update today
    [version3-2.FCStd]
